iOsnaaente/Totem-Alcool-em-gel/README.md

# Totem Alcool em gel - Projeto mecânico 

Detalhes das etapas de criação de um totem de álcool em gel feito em Solidworks 2019. 

Imagens do totem e referências no repositório Fotos

Desenhos 3D das peças no repositório Peças e compactados .rar em Projeto3D_TotemMecânico.rar 

Montagem do totem no arquivo Totem.STL e via software SolidWorks 2019 no repositório Montagens

Desenhos técnicos das estruturas em MDF no arquivo TotemDesTec.pdf e via software SolidWorks 2019 em TotemDesTec.SLDDRW

Lista de peças utilizadas no arquivo Totem_peças.xls 

Manual de montagem das peças utilizadas no repositório Manual e via software Solidworks Composer 2019 em Totem.smg

Texturas do corpo do totem no repositório Texturas
