iOsnaaente/Totem-Alcool-em-gel/Fotos/Back.jpg

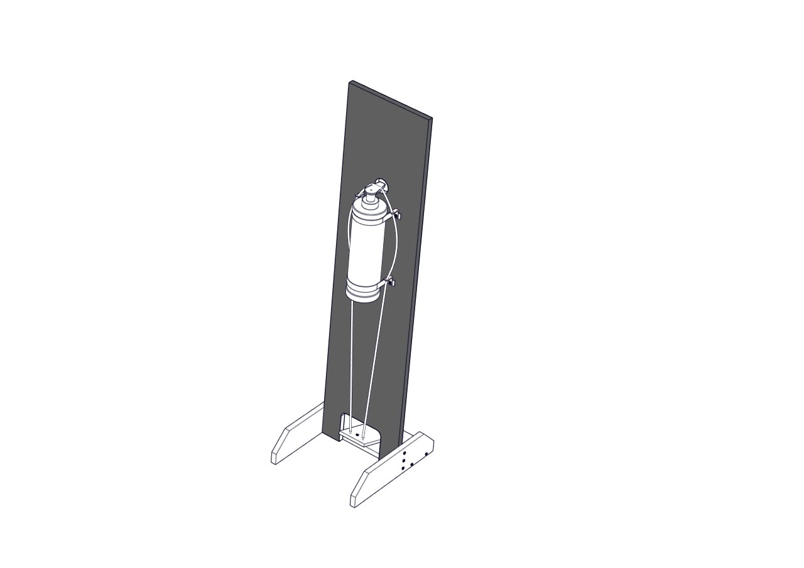
Fotos/Back.jpg
