iOsnaaente/Totem-Alcool-em-gel/Fotos/Explodida.jpg

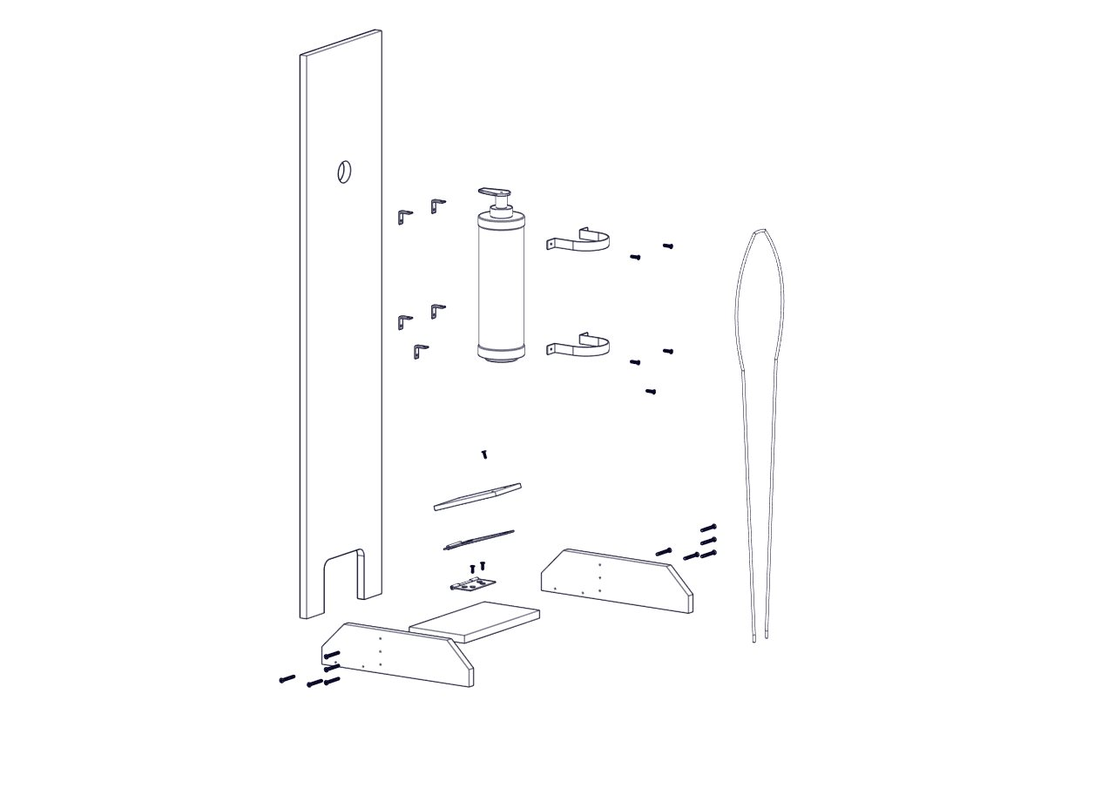
Fotos/Explodida.jpg
