iOsnaaente/Totem-Alcool-em-gel/Fotos/FrontTotem.jpg

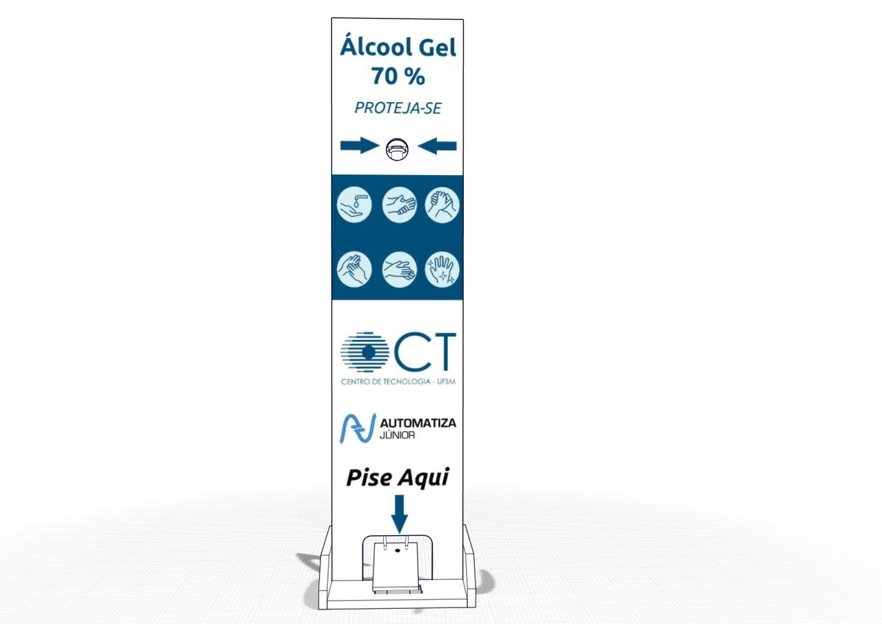
Fotos/FrontTotem.jpg
