iOsnaaente/Totem-Alcool-em-gel/Fotos/peças.jpg

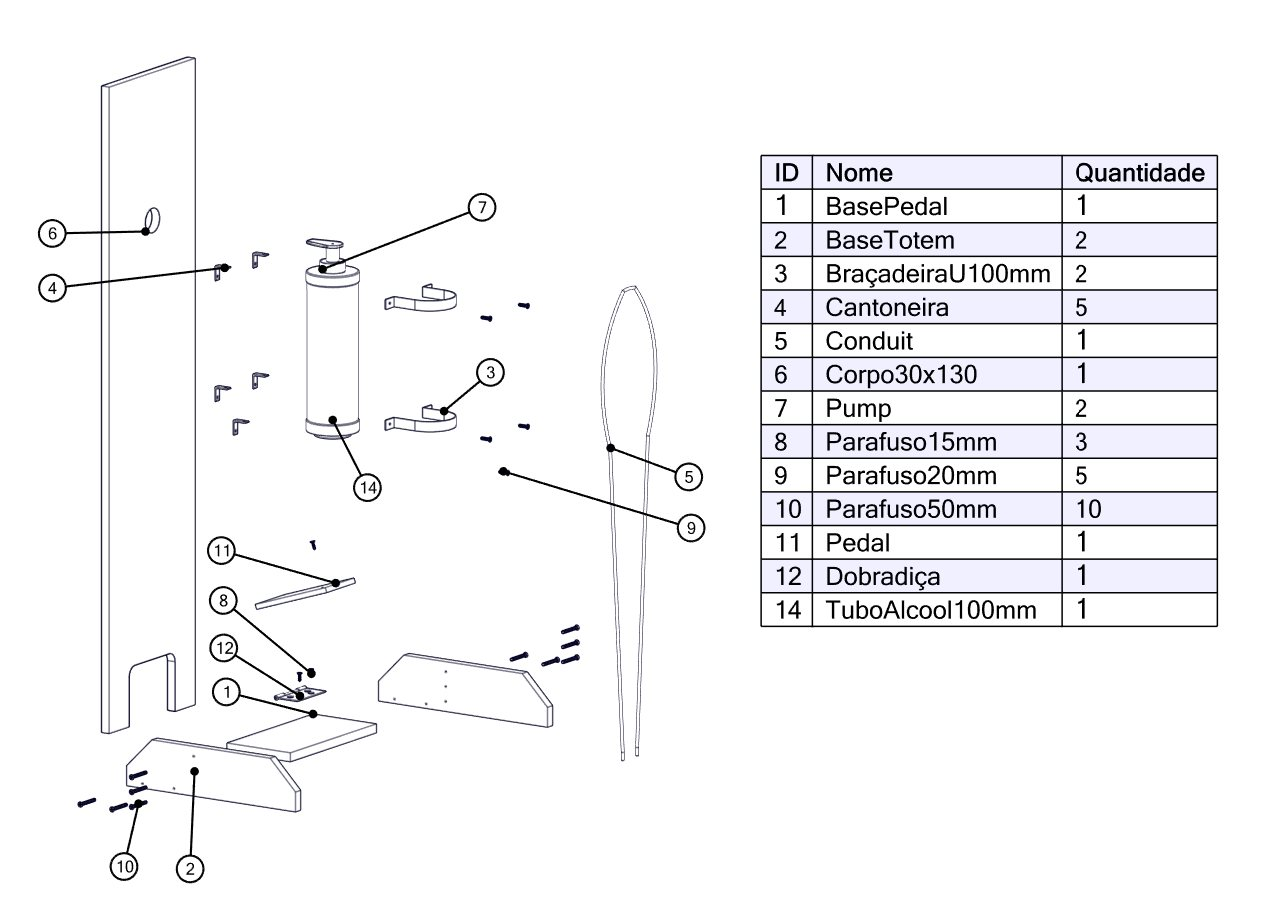
Fotos/peças.jpg
