iOsnaaente/Totem-Alcool-em-gel/Fotos/Totem.jpg

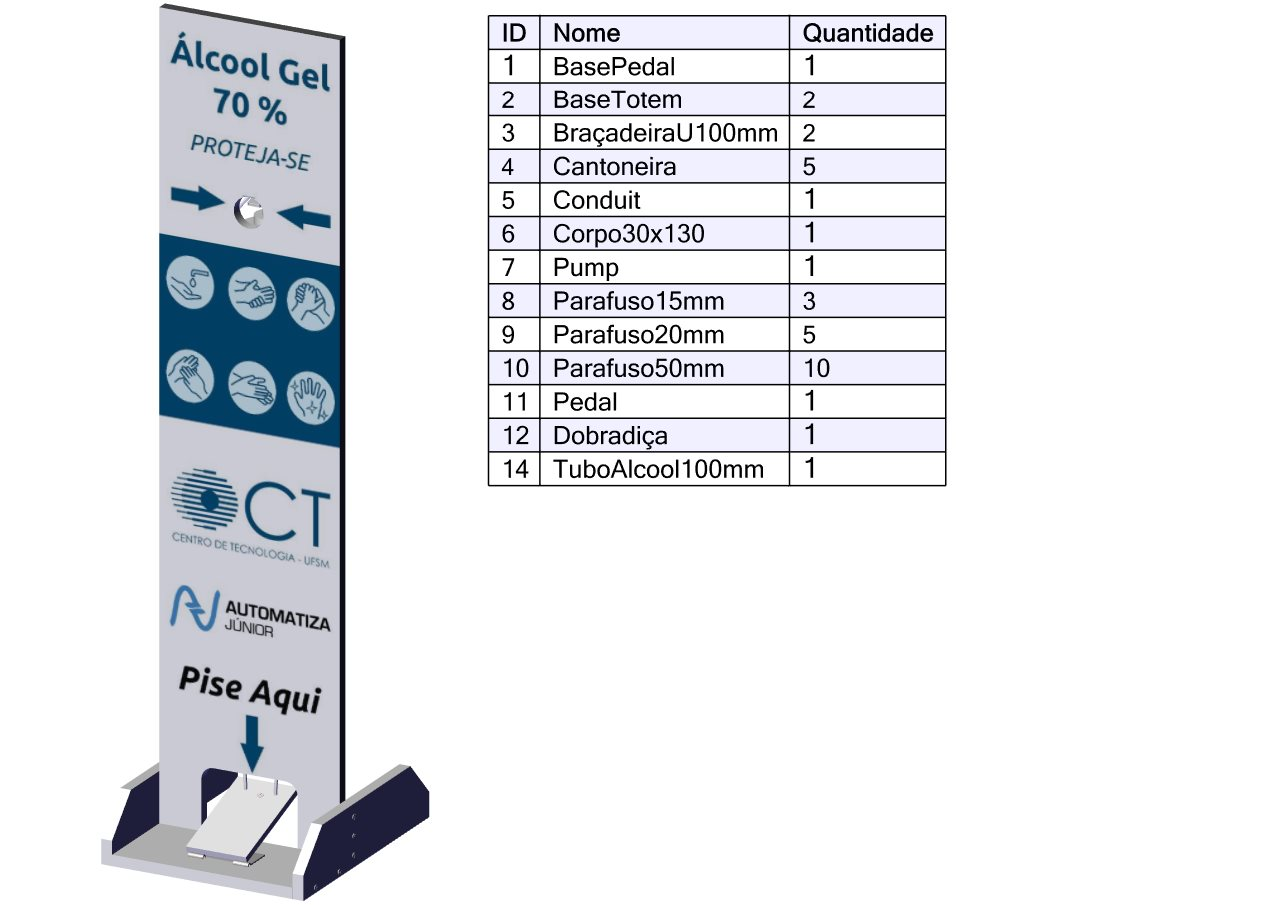
Fotos/Totem.jpg
