iOsnaaente/Totem-Alcool-em-gel/Texturas/ArteProjetar.jpg

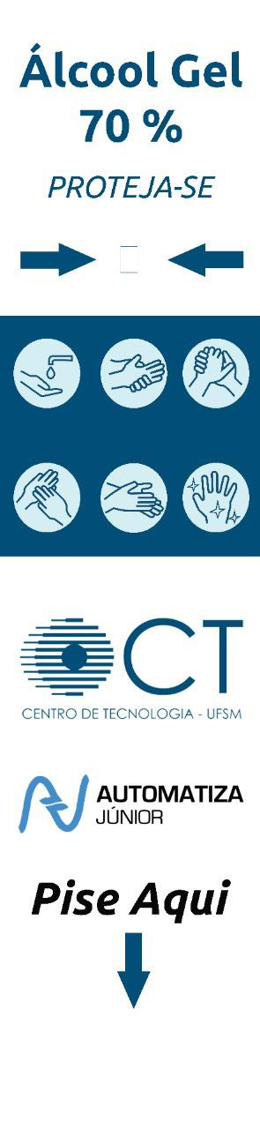
Texturas/ArteProjetar.jpg
