iOsnaaente/Totem-Alcool-em-gel/TOTEM30GRAUS.PNG

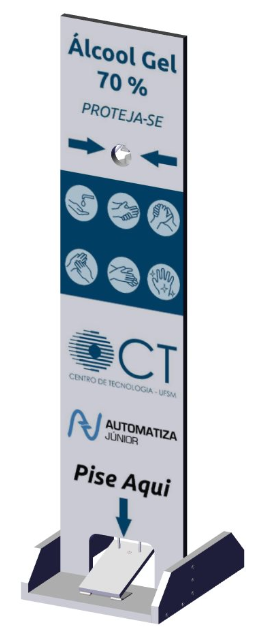
TOTEM30GRAUS.PNG
