iOsnaaente/Totem-Alcool-em-gel/Totem_peças.xls

Nº DO ITEM | Nº DA PEÇA | DESCRIÇÃO | QTD.
1 | Pé do Totem |  | 2
2 | Corpo |  | 1
3 | Pedal |  | 1
4 | Base entre pés |  | 1
5 | TuboAlcool 100mm | Tubo + tampas | 1
6 | Abraçadeira U 100mm |  | 2
7 | Dobradiça | Dobradiça de porteira | 1
8 | Cantoneiras |  | 5
9 | conduit | Conduit + Cabos de aço | 1
10 | Pump |  | 1
11 | parafuso 50mm c | 50mm de comprimento | 10
12 | parafuso 20mm c | 20mm de comprimento | 5
13 | parafuso 15mm c | 15mm de comprimento | 3
14 | Cola 3M | Fixação do pedal | -
15 | Cola pvc | Colagem do cap no cano | -
