iOsnaaente/Totem-Alcool-em-gel/Montagens/Totem.SLDASM

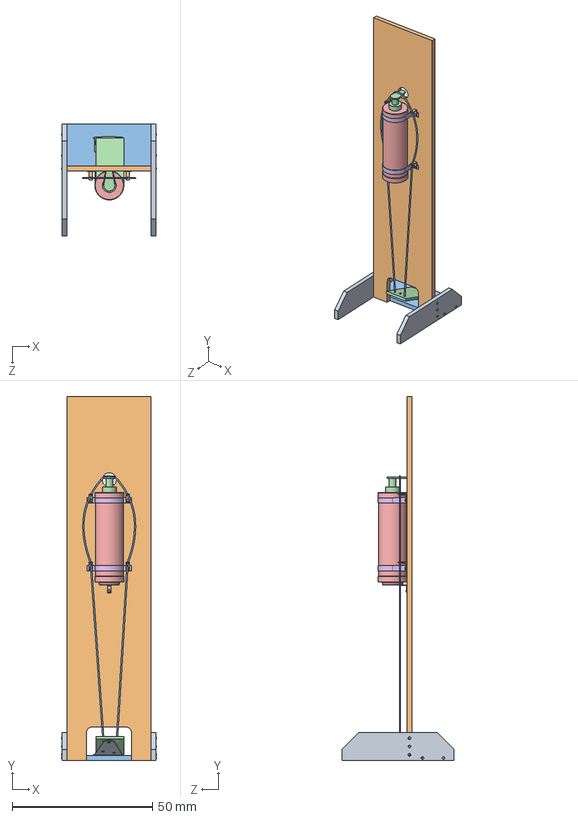
[picture p10: CAD file, 2021-02-19]
Montagens/Totem.SLDASM
34.0 x 130.0 x 40.0 mm
BaseTotem x 2
Corpo30x130
BasePedal_15x30
Pedal
TuboAlcool100mm
BraçadeiraU100mm x 2
PeçaInferior
Pivo
PeçaSuperior
Cantoneira x 5
Conduit_Cabo-de-aço
Pump
Parafuso50mm^Montagem1 x 10
Parafuso20mm^Montagem1 - Copia x 5
Parafuso15mm x 3
