iOsnaaente/Totem-Alcool-em-gel/Peças/Dobradiça/Dobradiça.SLDASM

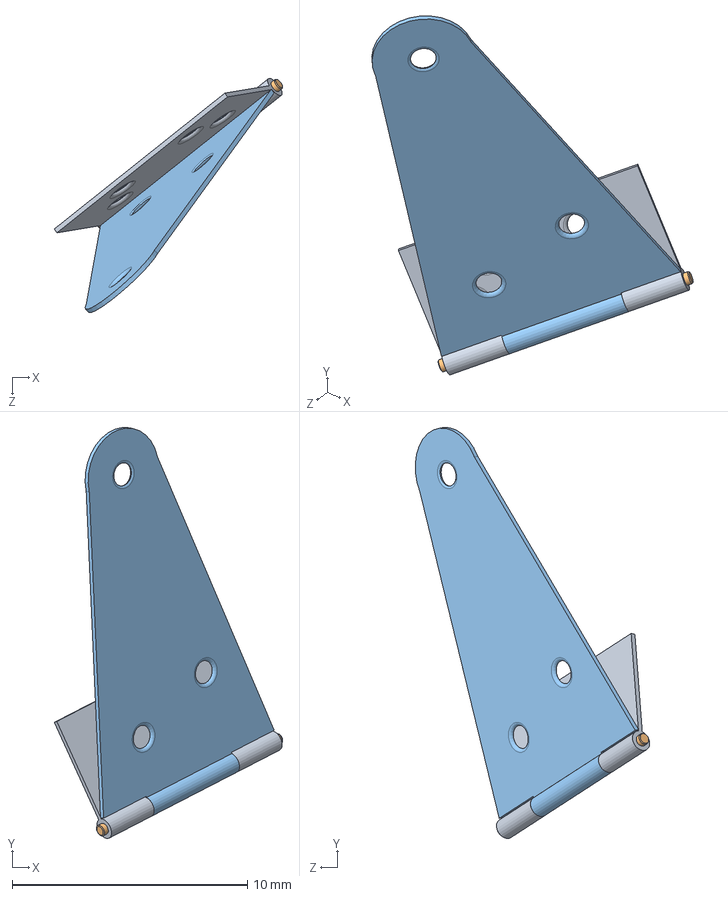
[picture p11: CAD file, 2021-01-08]
Peças/Dobradiça/Dobradiça.SLDASM
9.71 x 17.5 x 9.96 mm
PeçaInferior
Pivo
PeçaSuperior
