iOsnaaente/Totem-Alcool-em-gel/Montagens/Dobradiça.SLDASM

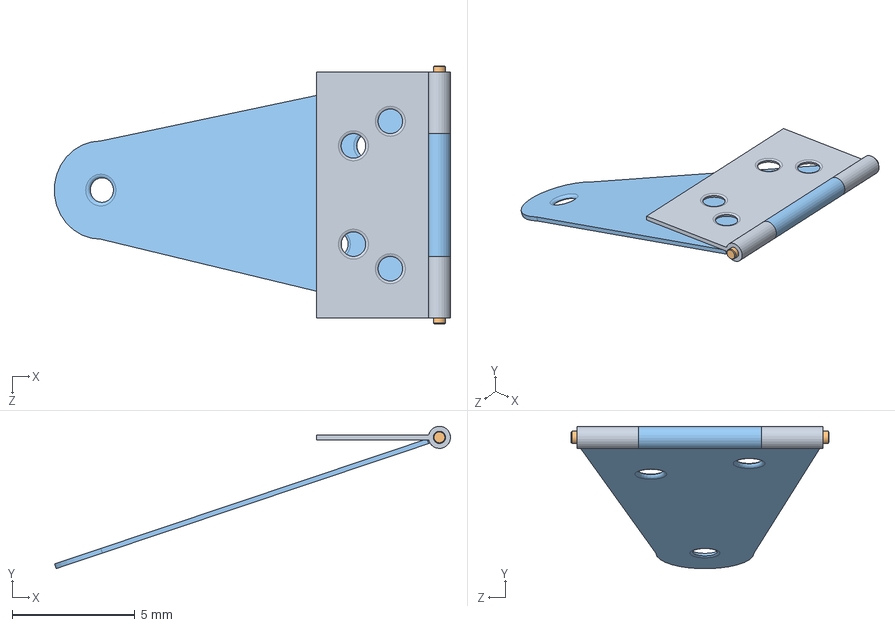
[picture p12: CAD file, 2021-01-08]
Montagens/Dobradiça.SLDASM
16.1 x 5.79 x 10.5 mm
PeçaInferior
Pivo
PeçaSuperior
