iOsnaaente/Totem-Alcool-em-gel/TOTEM_CCNE/TAG-403.SLDASM

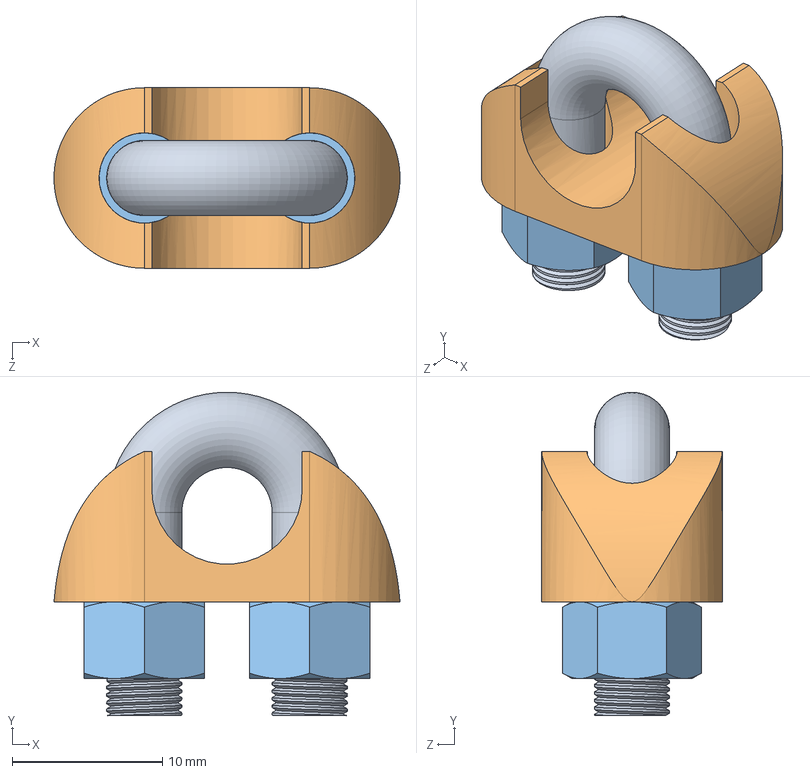
[picture p13: CAD file, 2021-02-19]
TOTEM_CCNE/TAG-403.SLDASM
23.0 x 21.5 x 12.0 mm
TAG-213.1
TAG-213.2
hex nut style 2_am x 2
