iOsnaaente/Totem-Alcool-em-gel/TOTEM_CCNE/TAG-401.SLDASM

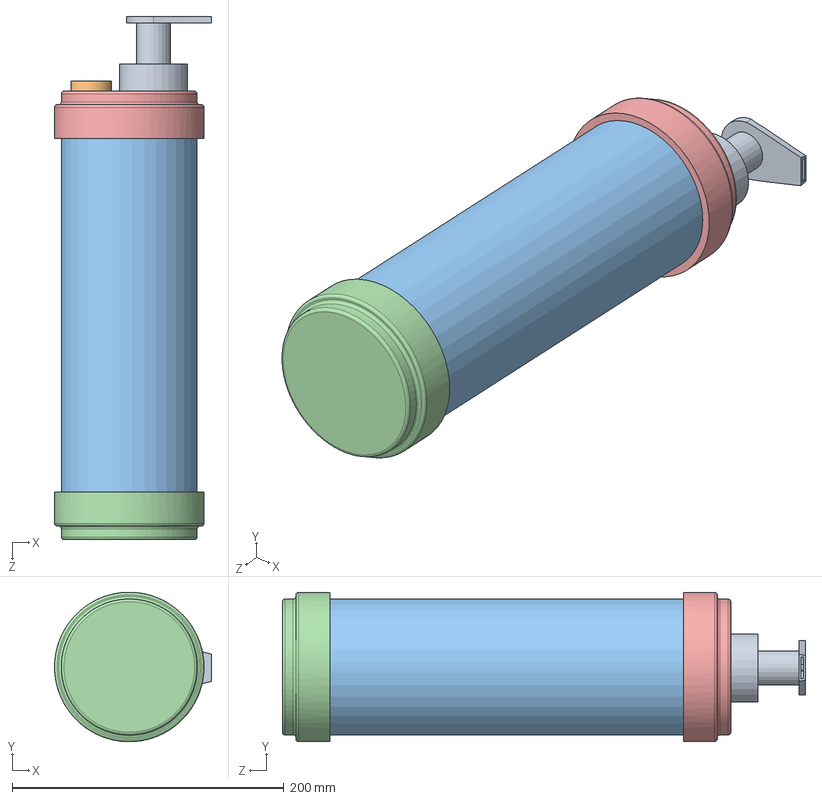
[picture p14: CAD file, 2021-02-19]
TOTEM_CCNE/TAG-401.SLDASM
115.5 x 110.0 x 385.0 mm
TAG-209
TAG-208
TAG-207
TAG-210
TAG-211
