iOsnaaente/Totem-Alcool-em-gel/TOTEM_CCNE/TAG-402.SLDASM

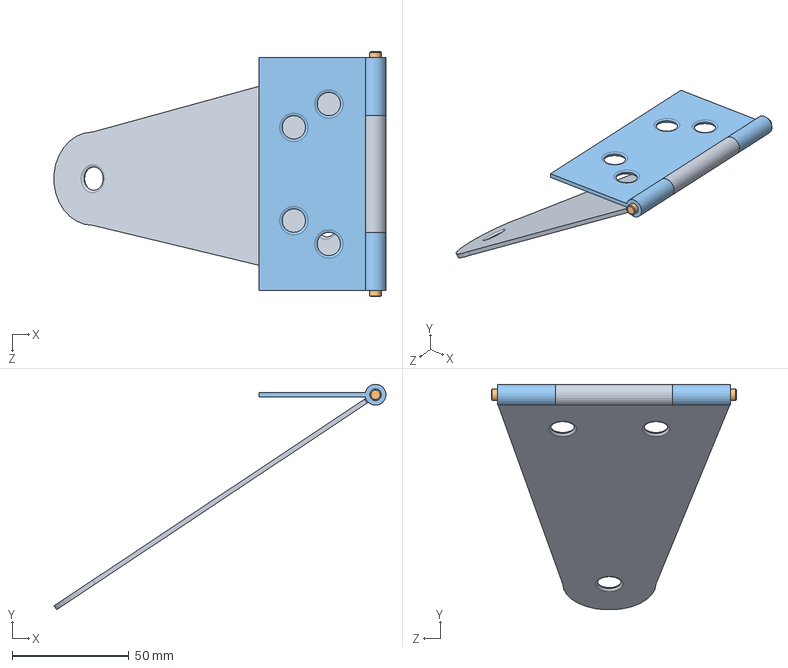
[picture p15: CAD file, 2021-02-19]
TOTEM_CCNE/TAG-402.SLDASM
142.3 x 96.7 x 105.0 mm
TAG-212.1
TAG-212.2
TAG-212.3
