iOsnaaente/Totem-Alcool-em-gel/TOTEM_CCNE/TAG-201.sldprt

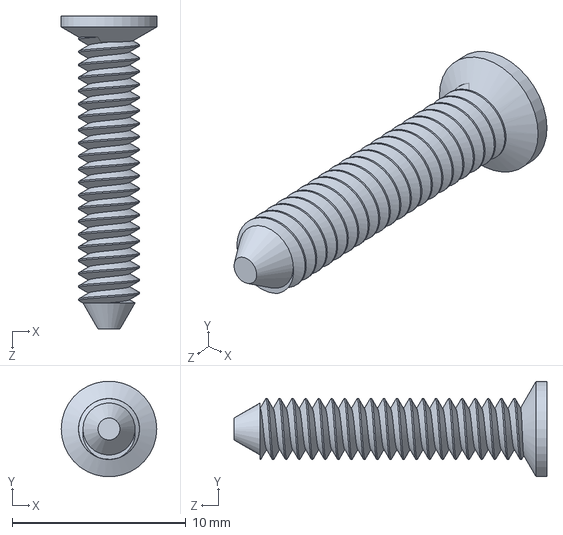
[picture p16: CAD file, 2021-02-19]
TOTEM_CCNE/TAG-201.sldprt
5.50 x 5.48 x 18.0 mm
