iOsnaaente/Totem-Alcool-em-gel/Peças/BaseTotem.SLDPRT

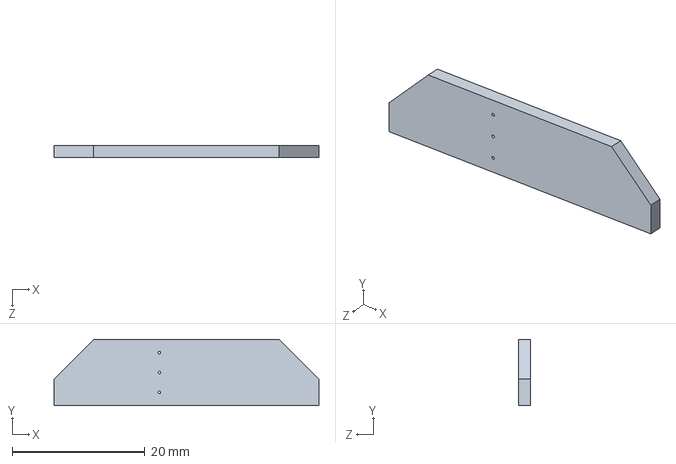
[picture p17: CAD file, 2021-02-19]
Peças/BaseTotem.SLDPRT
40.0 x 10.0 x 1.80 mm
