iOsnaaente/Totem-Alcool-em-gel/Peças/Dobradiça/PeçaInferior.sldprt

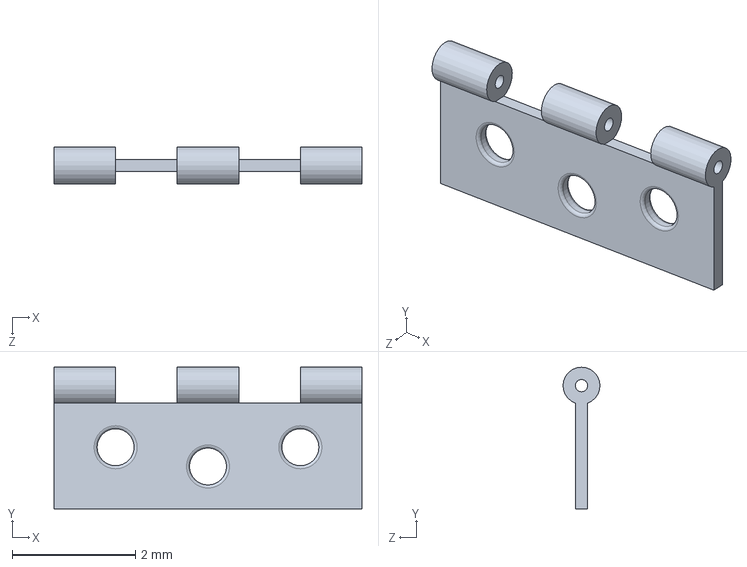
[picture p18: CAD file, 2021-01-08]
Peças/Dobradiça/PeçaInferior.sldprt
5.00 x 2.30 x 0.599 mm
