iOsnaaente/Totem-Alcool-em-gel/TOTEM_CCNE/TAG-104.sldprt

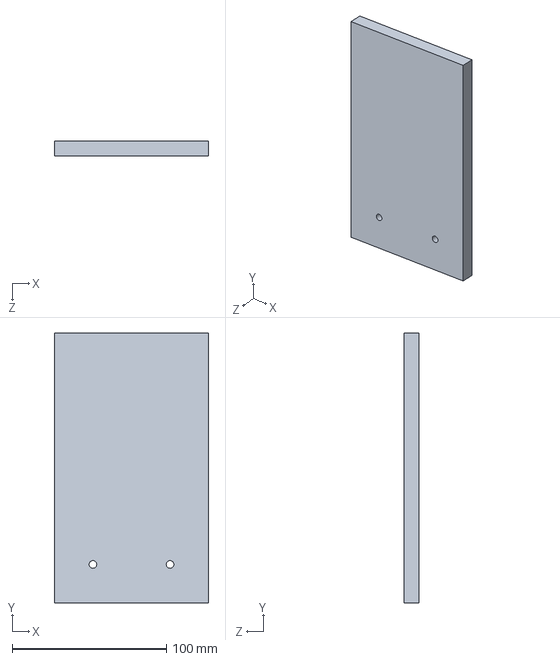
[picture p19: CAD file, 2021-02-19]
TOTEM_CCNE/TAG-104.sldprt
100.0 x 175.0 x 10.0 mm
