iOsnaaente/Totem-Alcool-em-gel/Peças/Pedal.sldprt

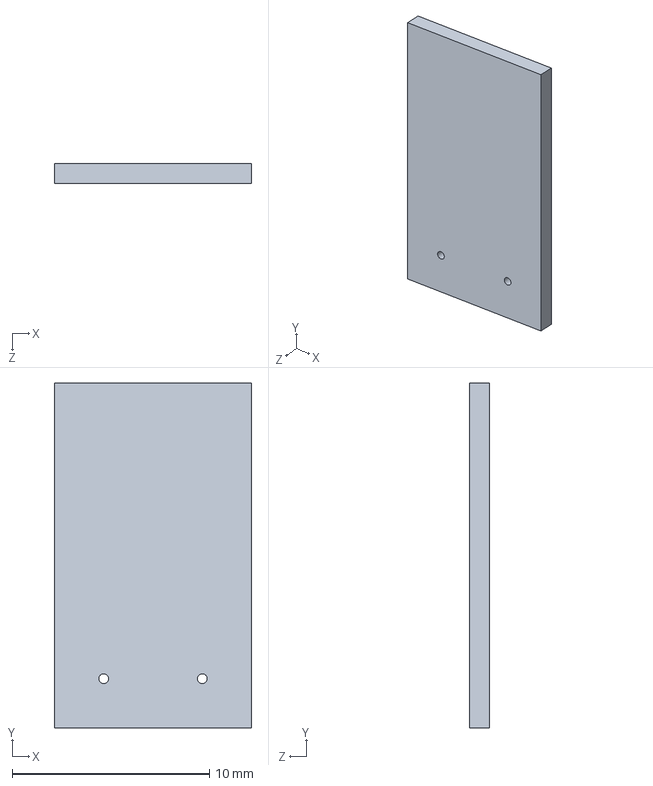
[picture p20: CAD file, 2021-01-19]
Peças/Pedal.sldprt
10.00 x 17.5 x 1.00 mm
