iOsnaaente/Totem-Alcool-em-gel/TOTEM_CCNE/TAG-212.1.sldprt

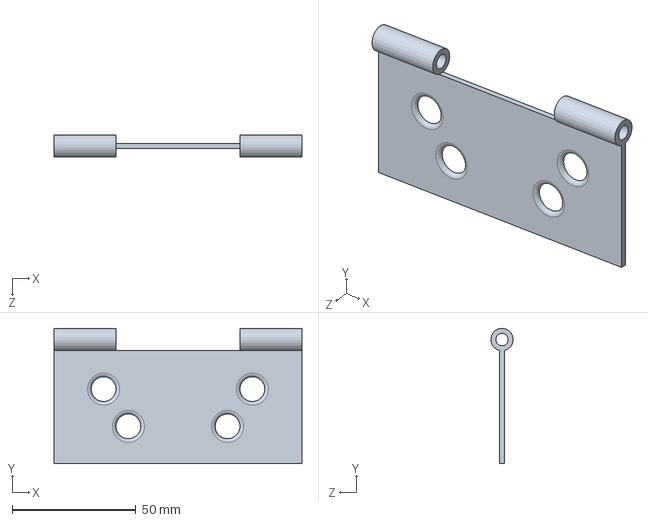
[picture p21: CAD file, 2021-02-19]
TOTEM_CCNE/TAG-212.1.sldprt
100.0 x 54.5 x 8.97 mm
