iOsnaaente/Totem-Alcool-em-gel/Peças/Corpo30x130.SLDPRT

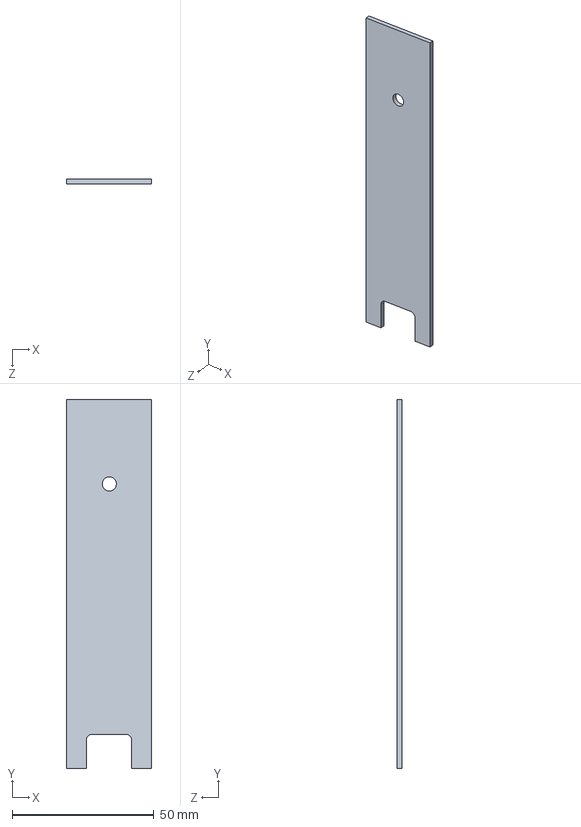
[picture p22: CAD file, 2021-01-08]
Peças/Corpo30x130.SLDPRT
30.0 x 130.0 x 1.80 mm
