iOsnaaente/Totem-Alcool-em-gel/TOTEM_CCNE/TAG-204.sldprt

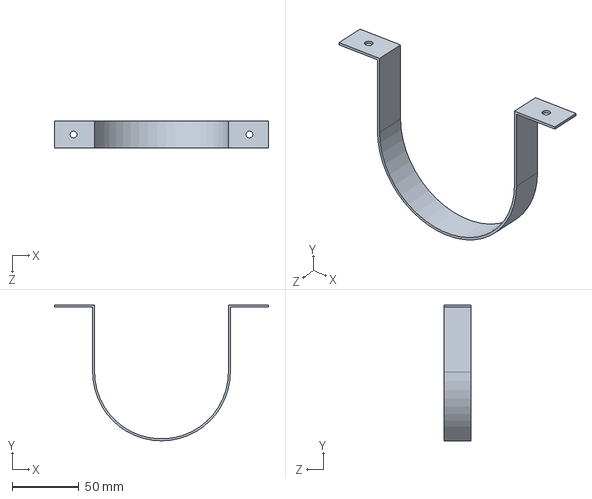
[picture p23: CAD file, 2021-02-19]
TOTEM_CCNE/TAG-204.sldprt
160.0 x 101.5 x 20.0 mm
