iOsnaaente/Totem-Alcool-em-gel/Peças/Cantoneira_pequena.sldprt

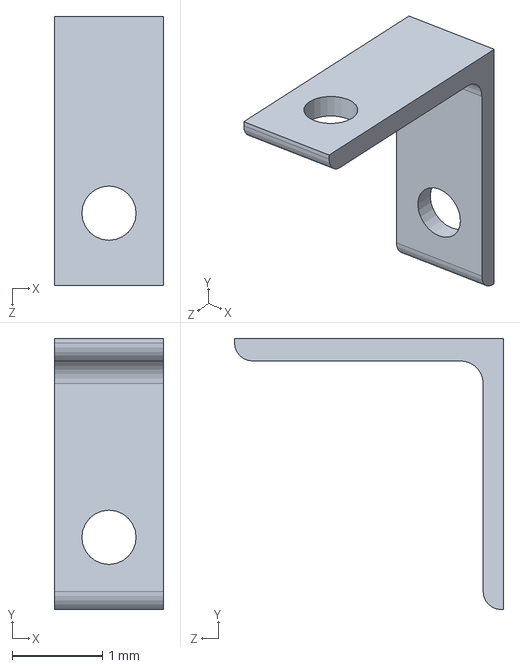
[picture p24: CAD file, 2021-01-08]
Peças/Cantoneira_pequena.sldprt
1.20 x 3.00 x 2.98 mm
