iOsnaaente/Totem-Alcool-em-gel/TOTEM_CCNE/TAG-304.SLDPRT

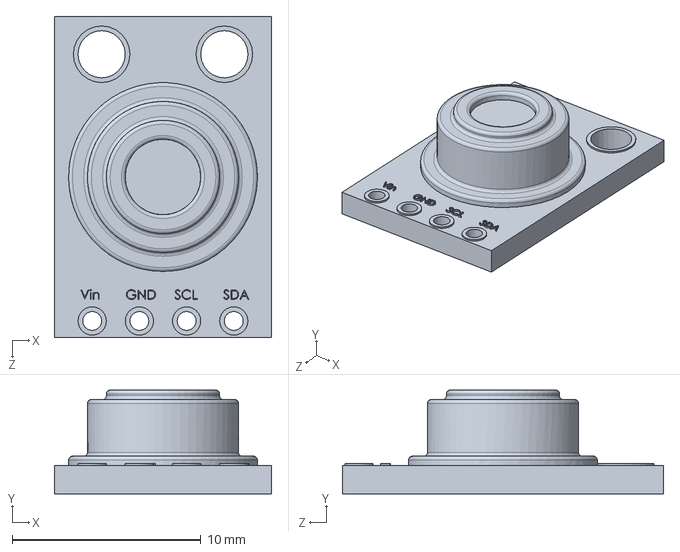
[picture p25: CAD file, 2021-02-19]
TOTEM_CCNE/TAG-304.SLDPRT
11.5 x 5.50 x 17.0 mm
