iOsnaaente/Totem-Alcool-em-gel/Peças/TuboAlcool100mm.sldprt

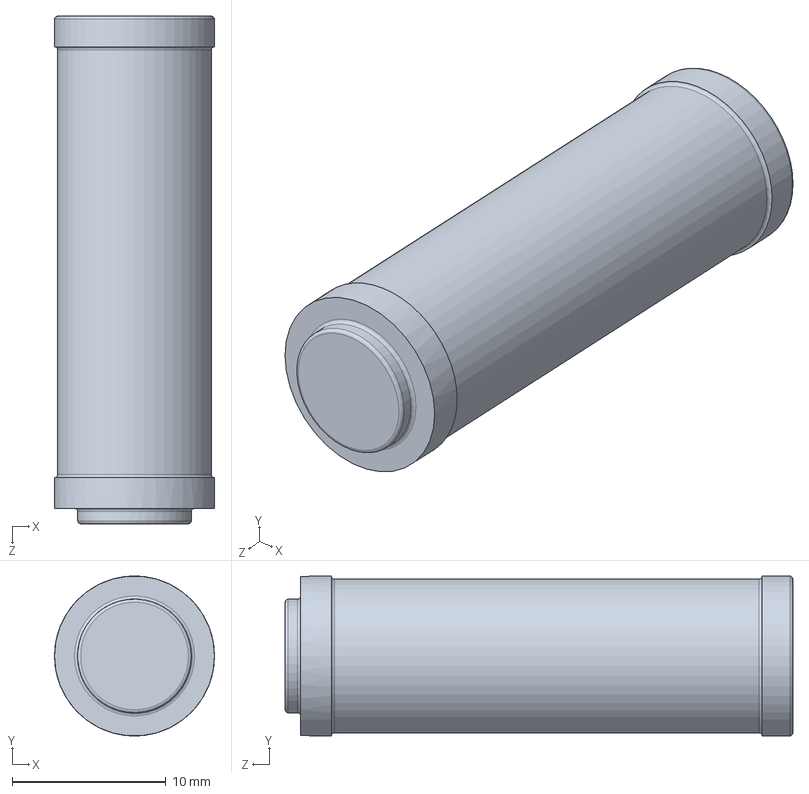
[picture p26: CAD file, 2021-01-08]
Peças/TuboAlcool100mm.sldprt
10.4 x 10.4 x 33.0 mm
