iOsnaaente/Totem-Alcool-em-gel/TOTEM_CCNE/TAG-102.SLDPRT

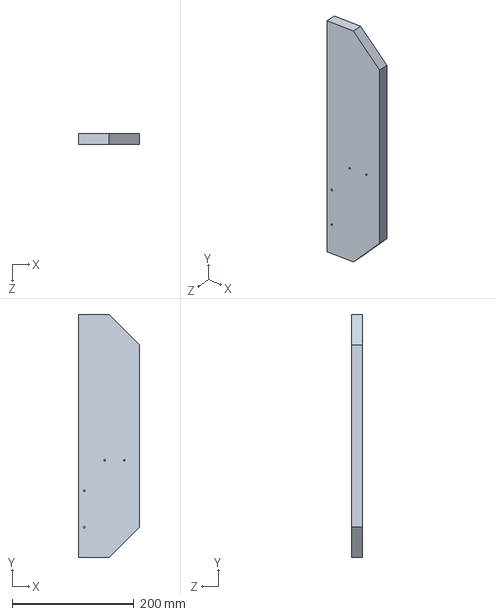
[picture p27: CAD file, 2021-02-19]
TOTEM_CCNE/TAG-102.SLDPRT
100.0 x 400.0 x 18.0 mm
