iOsnaaente/Totem-Alcool-em-gel/Peças/Pump.sldprt

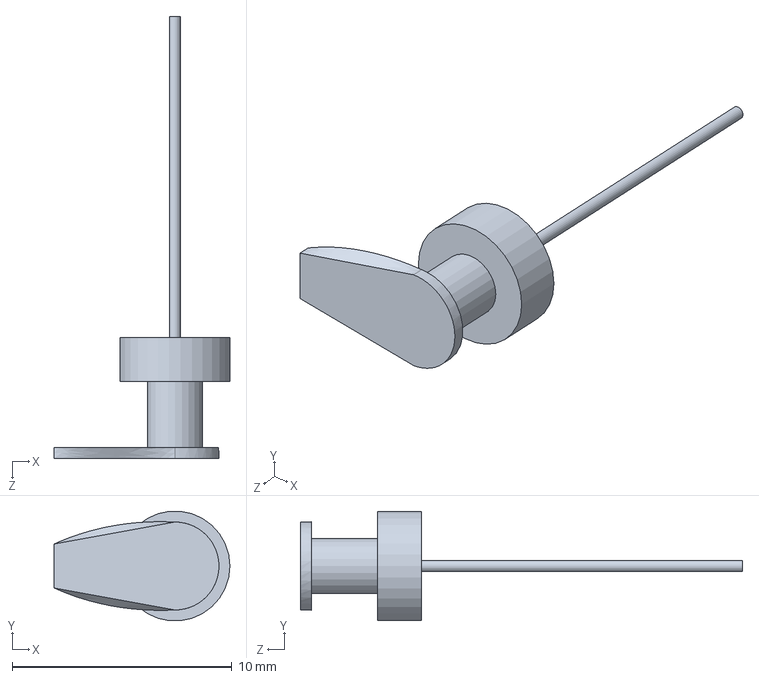
[picture p28: CAD file, 2021-01-08]
Peças/Pump.sldprt
8.00 x 4.97 x 20.1 mm
