iOsnaaente/Totem-Alcool-em-gel/TOTEM_CCNE/TAG-101.sldprt

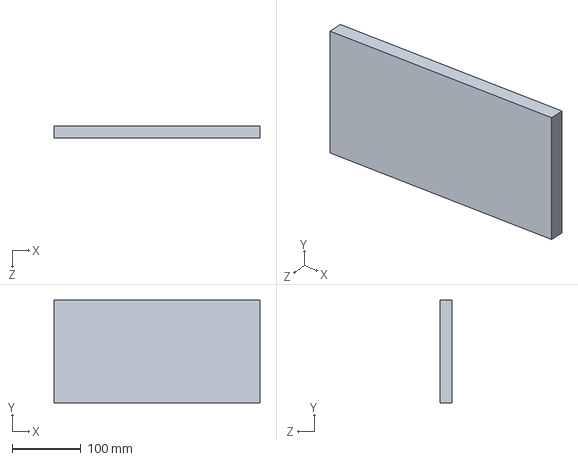
[picture p29: CAD file, 2021-02-19]
TOTEM_CCNE/TAG-101.sldprt
300.0 x 150.0 x 18.0 mm
