iOsnaaente/Totem-Alcool-em-gel/TOTEM_CCNE/TAG-207.sldprt

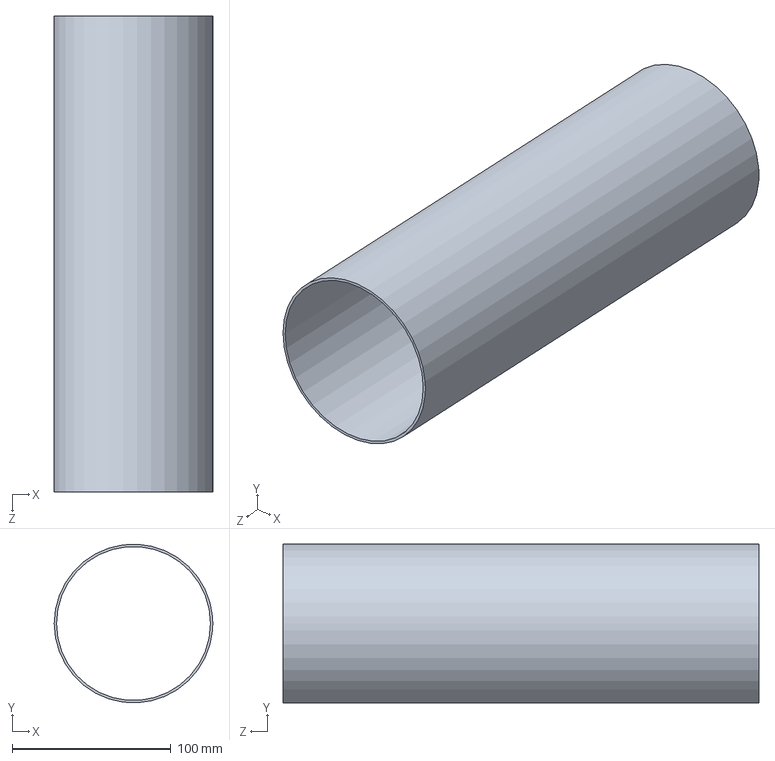
[picture p30: CAD file, 2021-02-19]
TOTEM_CCNE/TAG-207.sldprt
100.0 x 99.9 x 300.0 mm
