iOsnaaente/Totem-Alcool-em-gel/Peças/Parafuso20mm^Montagem1 - Copia.sldprt

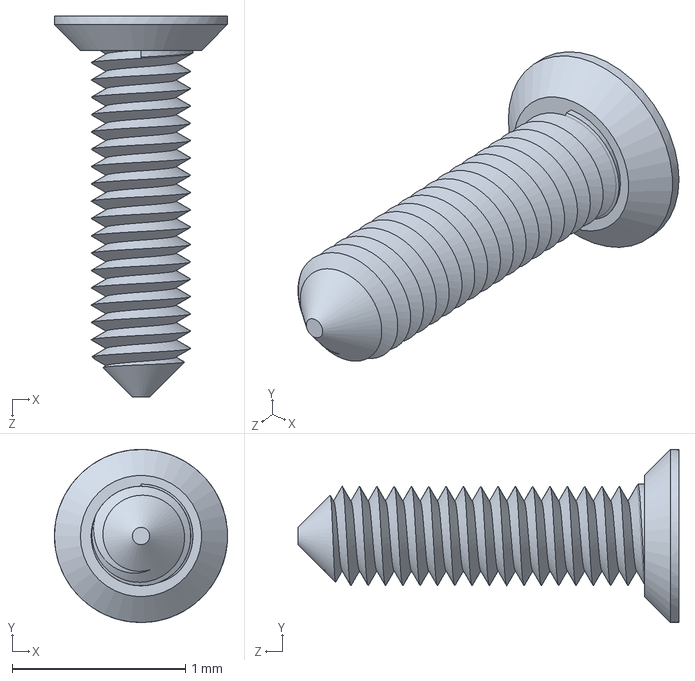
[picture p31: CAD file, 2021-01-08]
Peças/Parafuso20mm^Montagem1 - Copia.sldprt
1.00 x 0.999 x 2.20 mm
