iOsnaaente/Totem-Alcool-em-gel/TOTEM_CCNE/TAG-212.3.SLDPRT

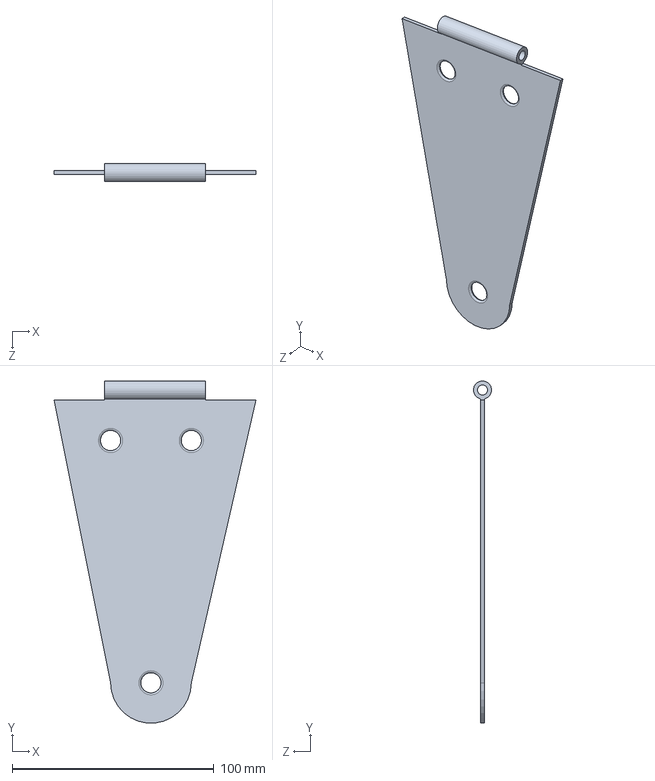
[picture p32: CAD file, 2021-02-19]
TOTEM_CCNE/TAG-212.3.SLDPRT
100.0 x 169.4 x 8.97 mm
