iOsnaaente/Totem-Alcool-em-gel/Peças/Parafuso15mm.sldprt

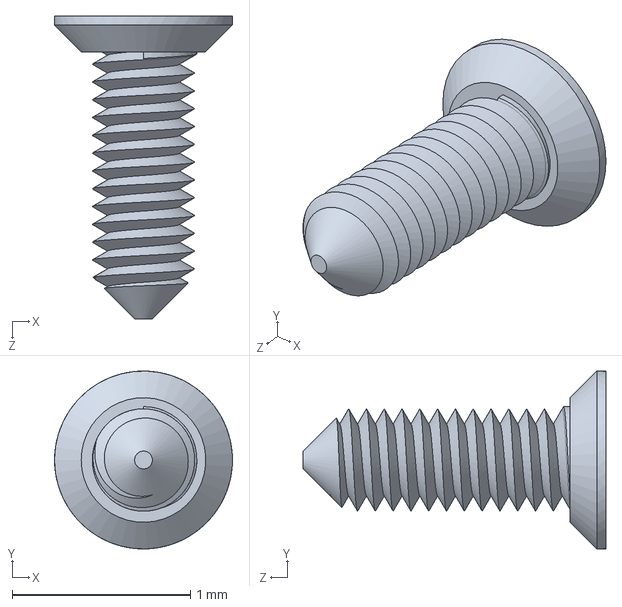
[picture p33: CAD file, 2021-01-08]
Peças/Parafuso15mm.sldprt
1.00 x 0.999 x 1.70 mm
