iOsnaaente/Totem-Alcool-em-gel/TOTEM_CCNE/TAG-203.sldprt

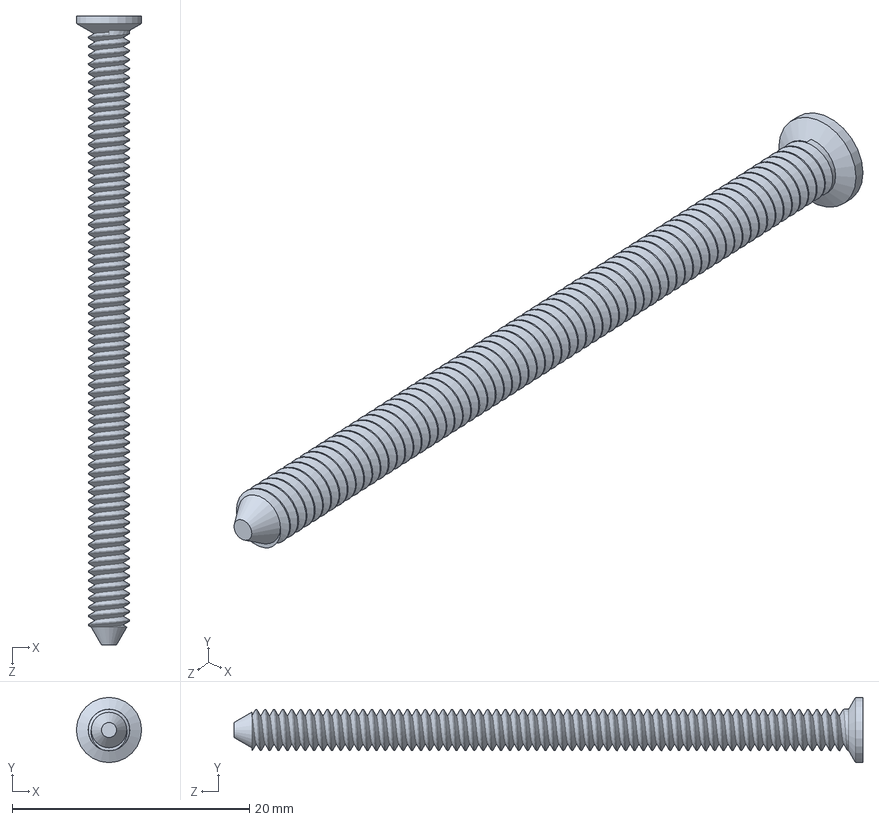
[picture p34: CAD file, 2021-02-19]
TOTEM_CCNE/TAG-203.sldprt
5.50 x 5.50 x 53.0 mm
