iOsnaaente/Totem-Alcool-em-gel/Peças/Parafuso50mm^Montagem1.sldprt

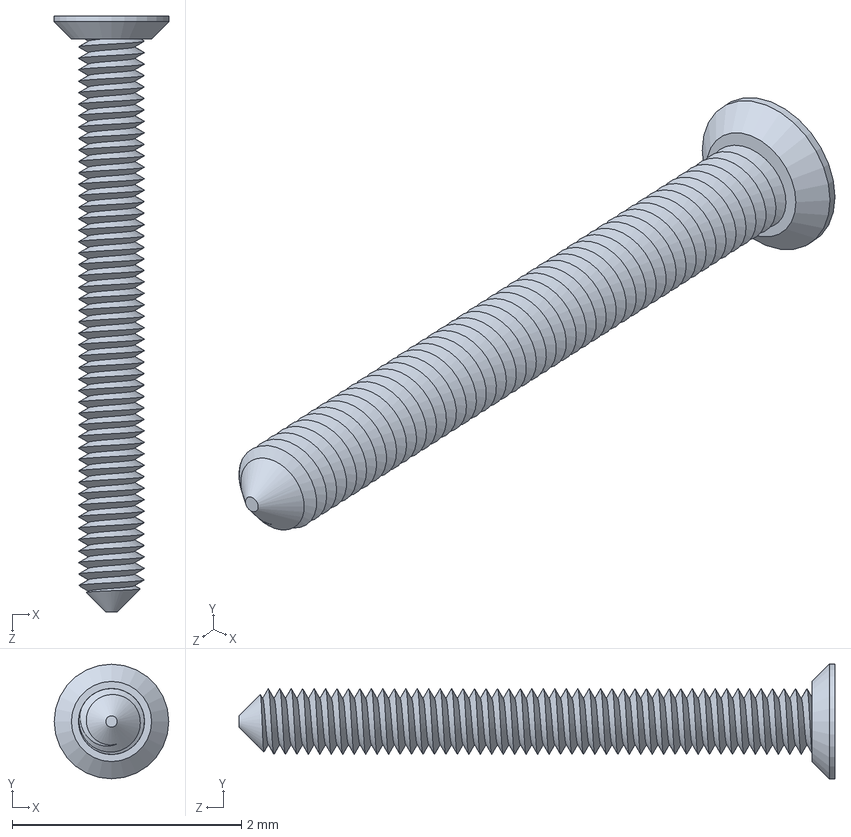
[picture p35: CAD file, 2021-01-08]
Peças/Parafuso50mm^Montagem1.sldprt
1.00 x 1.00 x 5.20 mm
