iOsnaaente/Totem-Alcool-em-gel/TOTEM_CCNE/TAG-213.1.SLDPRT

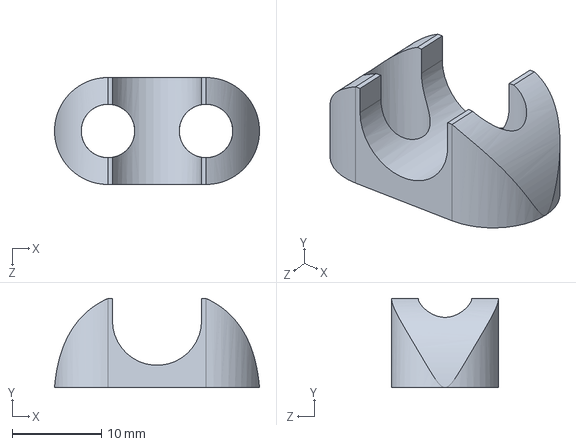
[picture p37: CAD file, 2021-02-19]
TOTEM_CCNE/TAG-213.1.SLDPRT
23.0 x 10.0 x 12.0 mm
