iOsnaaente/Totem-Alcool-em-gel/TOTEM_CCNE/TAG-205.sldprt

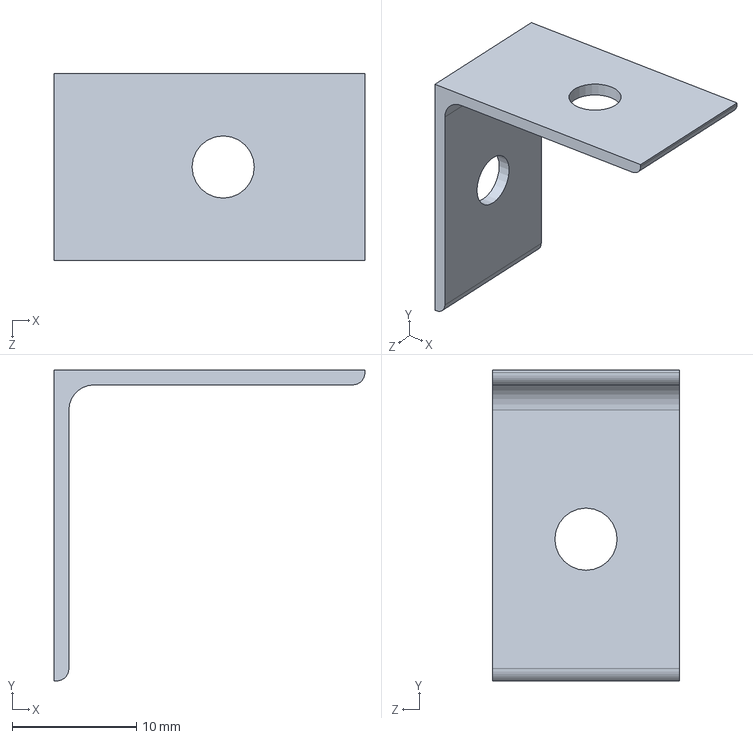
[picture p38: CAD file, 2021-02-19]
TOTEM_CCNE/TAG-205.sldprt
25.0 x 25.0 x 15.0 mm
