iOsnaaente/Totem-Alcool-em-gel/TOTEM_CCNE/TAG-103.SLDPRT

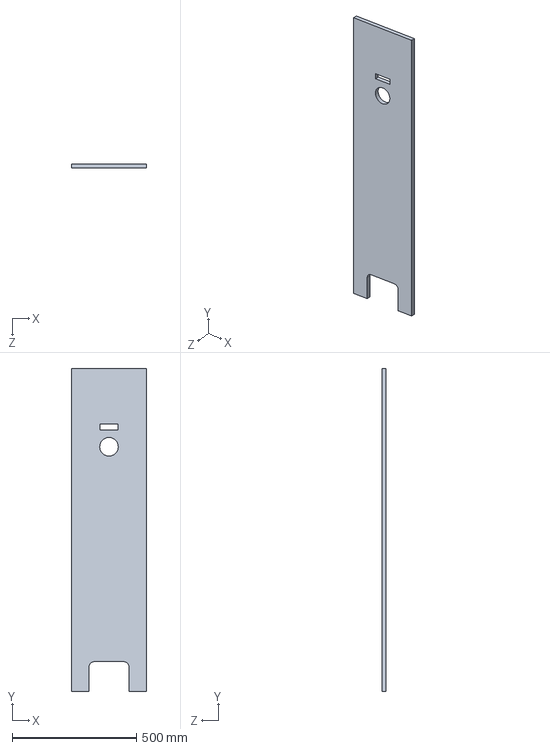
[picture p39: CAD file, 2021-02-19]
TOTEM_CCNE/TAG-103.SLDPRT
300.0 x 1300.0 x 18.0 mm
