iOsnaaente/Totem-Alcool-em-gel/TOTEM_CCNE/TAG-213.2.SLDPRT

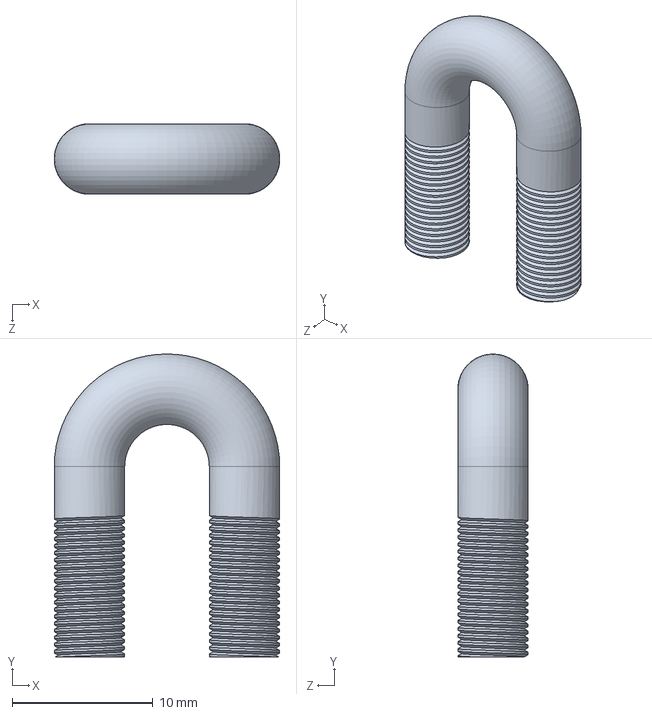
[picture p41: CAD file, 2021-02-19]
TOTEM_CCNE/TAG-213.2.SLDPRT
16.0 x 21.5 x 5.00 mm
