iOsnaaente/Totem-Alcool-em-gel/TOTEM_CCNE/TAG-305.sldprt

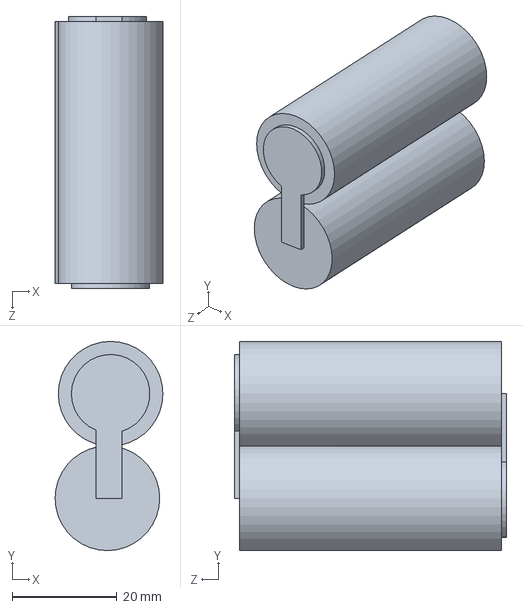
[picture p42: CAD file, 2021-02-19]
TOTEM_CCNE/TAG-305.sldprt
20.6 x 40.0 x 52.0 mm
