iOsnaaente/Totem-Alcool-em-gel/TOTEM_CCNE/TAG-209.sldprt

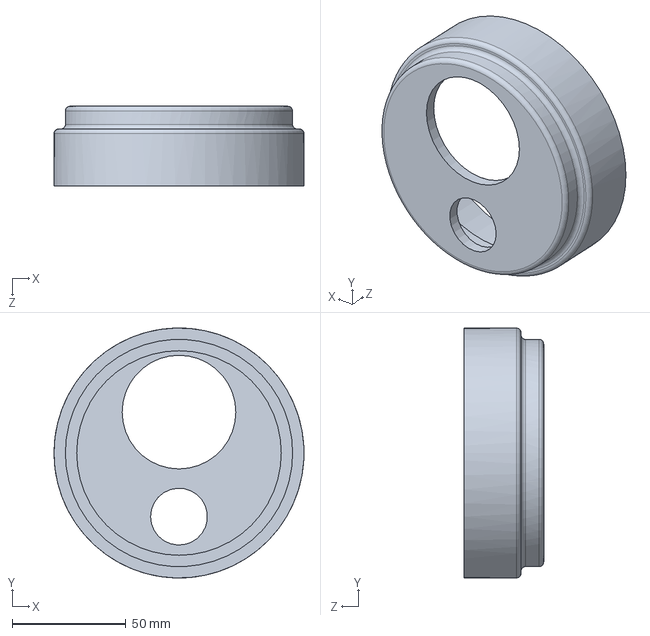
[picture p43: CAD file, 2021-02-19]
TOTEM_CCNE/TAG-209.sldprt
110.0 x 110.0 x 35.0 mm
