iOsnaaente/Totem-Alcool-em-gel/TOTEM_CCNE/TAG-211.sldprt

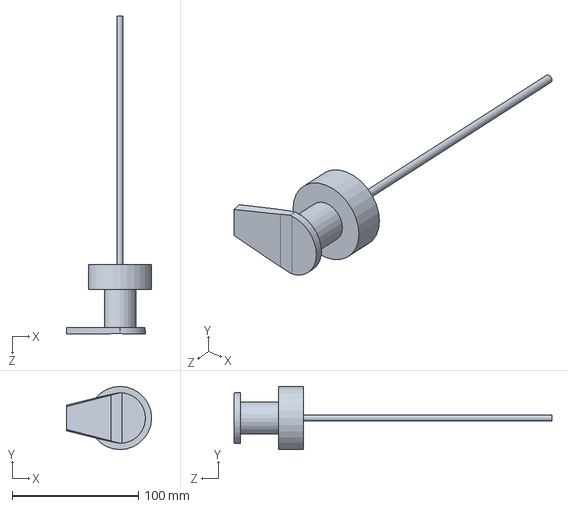
[picture p44: CAD file, 2021-02-19]
TOTEM_CCNE/TAG-211.sldprt
67.5 x 50.0 x 251.5 mm
