iOsnaaente/Totem-Alcool-em-gel/TOTEM_CCNE/TAG-202.sldprt

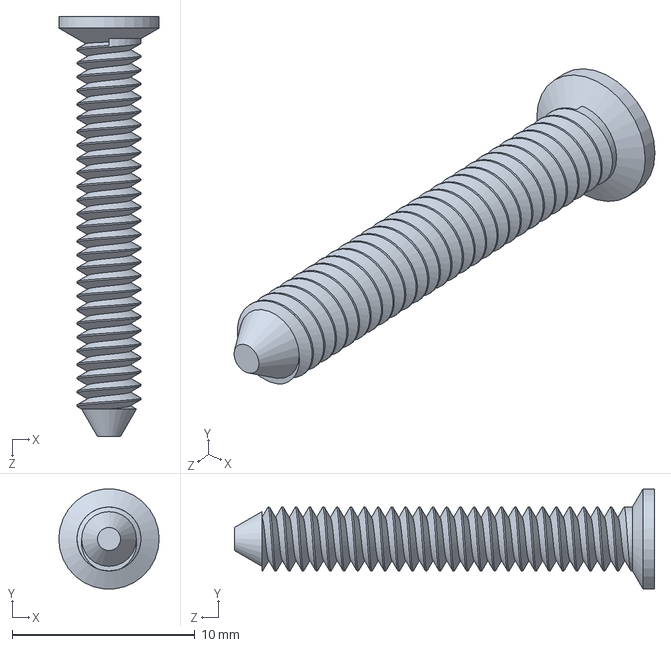
[picture p45: CAD file, 2021-02-19]
TOTEM_CCNE/TAG-202.sldprt
5.50 x 5.47 x 23.0 mm
