iOsnaaente/Totem-Alcool-em-gel/TOTEM_CCNE/TAG-212.2.sldprt

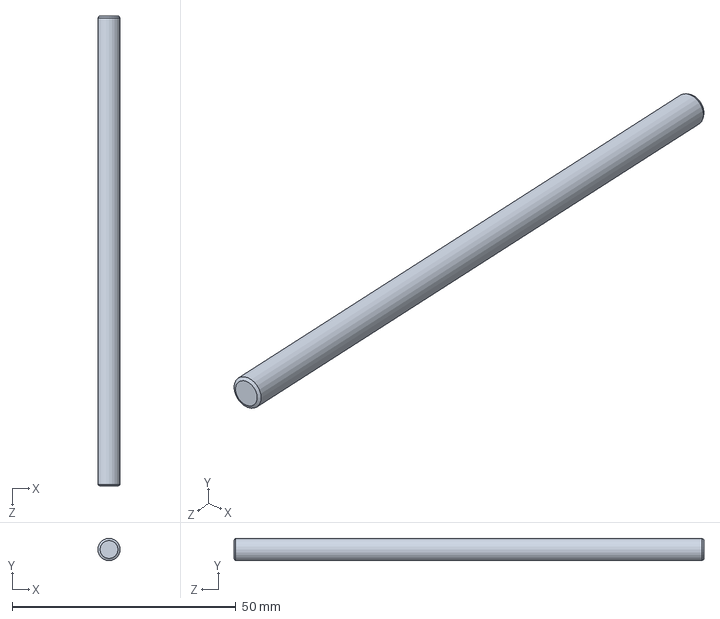
[picture p46: CAD file, 2021-02-19]
TOTEM_CCNE/TAG-212.2.sldprt
5.00 x 5.00 x 105.0 mm
