iOsnaaente/Totem-Alcool-em-gel/TOTEM_CCNE/TAG-210.sldprt

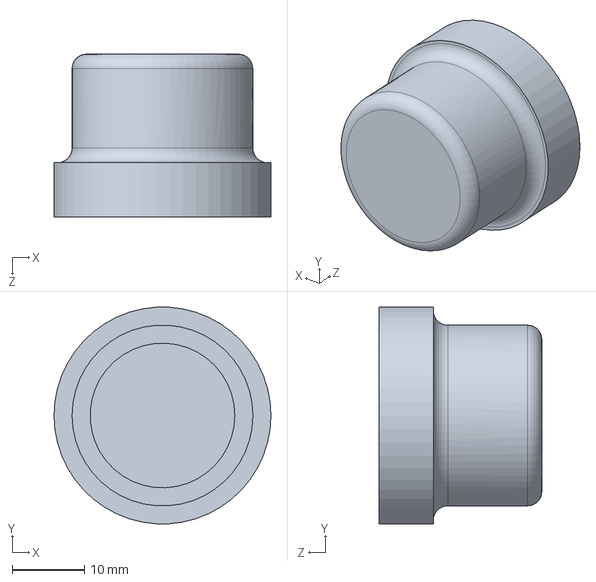
[picture p47: CAD file, 2021-02-19]
TOTEM_CCNE/TAG-210.sldprt
30.0 x 29.9 x 22.5 mm
