iOsnaaente/Totem-Alcool-em-gel/TOTEM_CCNE/TAG-206.sldprt

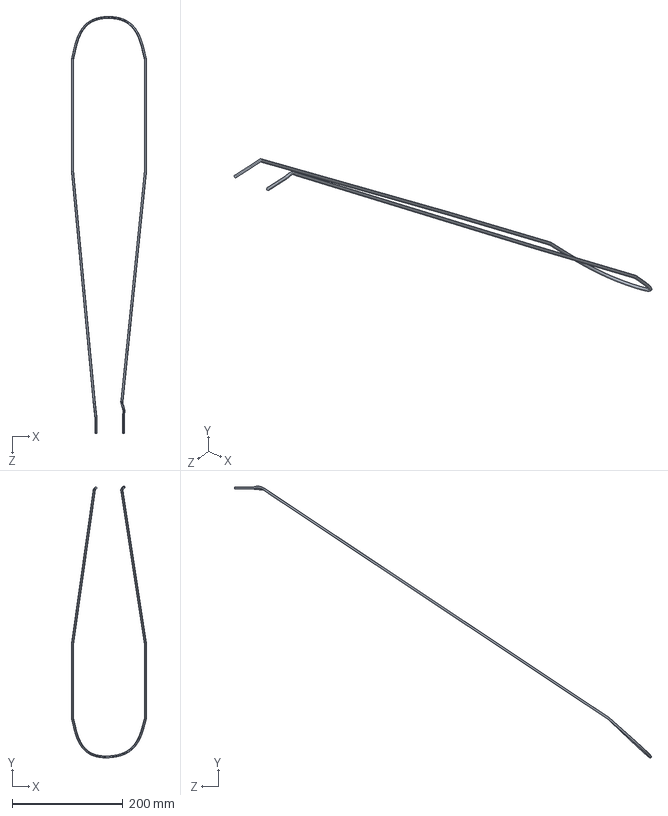
[picture p48: CAD file, 2021-02-19]
TOTEM_CCNE/TAG-206.sldprt
135.5 x 490.3 x 752.5 mm
