iOsnaaente/Totem-Alcool-em-gel/TOTEM_CCNE/TAG-301.SLDPRT

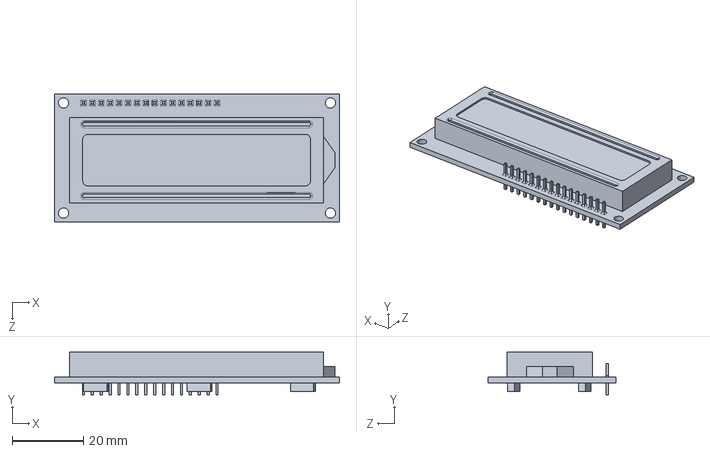
[picture p49: CAD file, 2021-02-19]
TOTEM_CCNE/TAG-301.SLDPRT
80.0 x 12.0 x 36.0 mm
