iOsnaaente/Totem-Alcool-em-gel/TOTEM_CCNE/TAG-105.sldprt

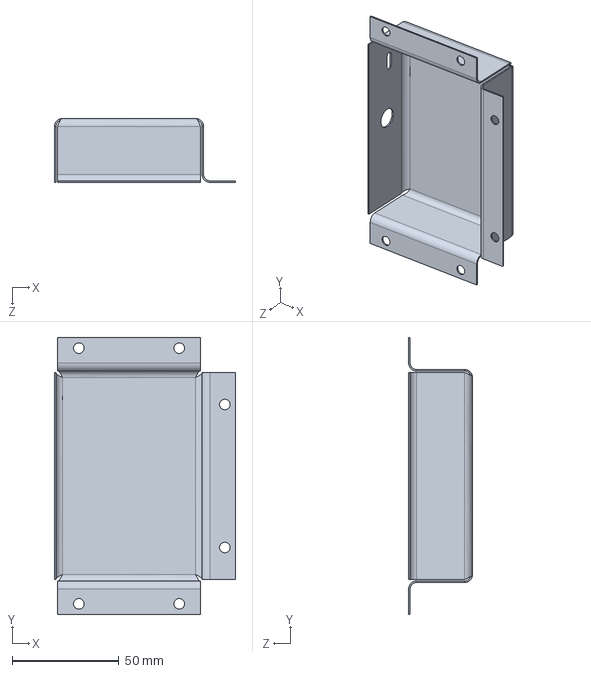
[picture p50: CAD file, 2021-02-19]
TOTEM_CCNE/TAG-105.sldprt
85.0 x 130.0 x 30.0 mm
