iOsnaaente/Totem-Alcool-em-gel/(list of files, cad)

Other CAD files:
Peças/Conduit_Cabo-de-aço.sldprt
Peças/Dobradiça/Pivo.sldprt
Peças/Dobradiça/PeçaSuperior.SLDPRT
Peças/BasePedal_15x30.sldprt
Peças/BraçadeiraU100mm.sldprt
Peças/Cantoneira.sldprt
TOTEM_CCNE/TAG-101.SLDDRW
TOTEM_CCNE/TAG-102.SLDDRW
TOTEM_CCNE/TAG-103.SLDDRW
TOTEM_CCNE/TAG-104.SLDDRW
TOTEM_CCNE/TAG-105.SLDDRW
TOTEM_CCNE/TAG-401.SLDDRW
TOTEM_CCNE/TAG-501.SLDDRW
TotemDesTec.SLDDRW
