iOsnaaente/Totem-Alcool-em-gel/Manual/PNGs/1.png

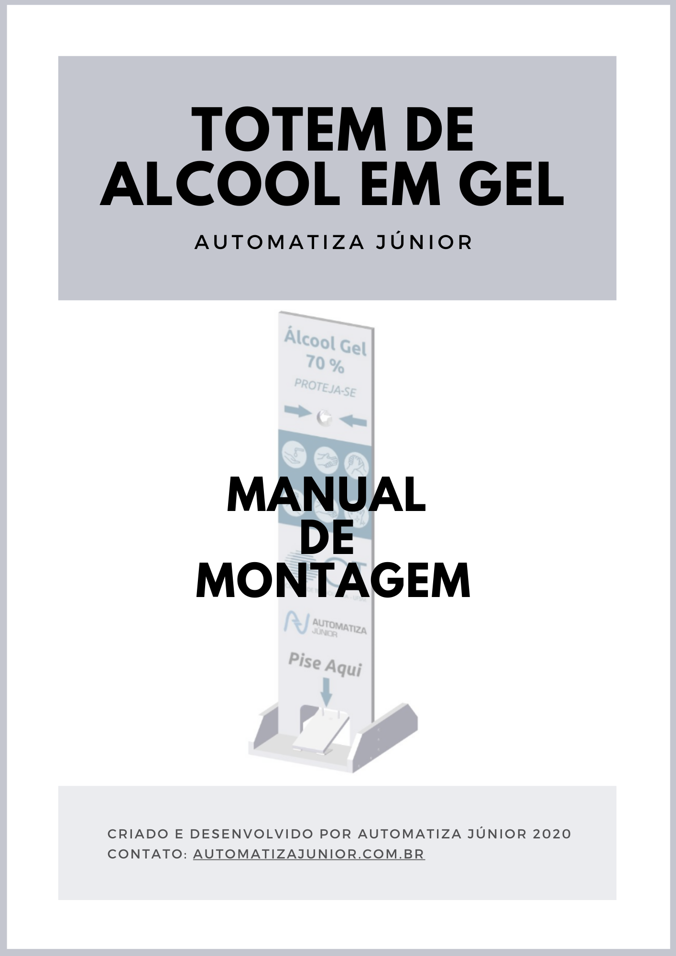
Manual/PNGs/1.png
