iOsnaaente/Totem-Alcool-em-gel/Manual/PNGs/2.png

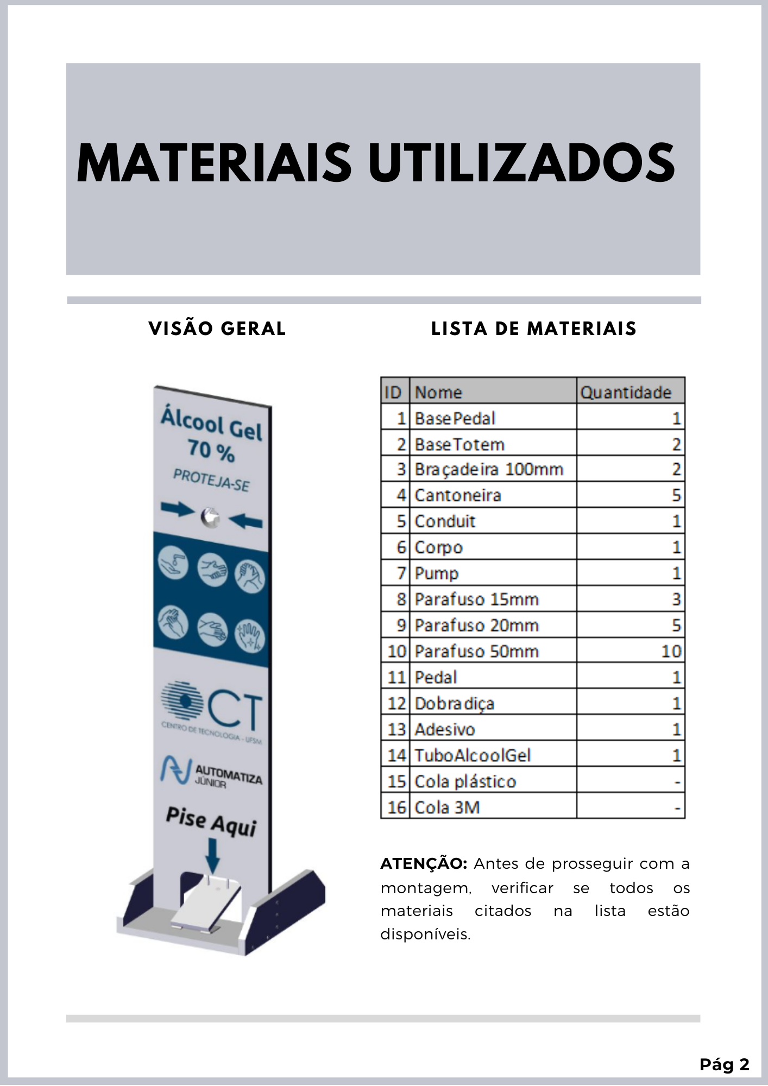
Manual/PNGs/2.png
