iOsnaaente/Totem-Alcool-em-gel/Manual/PNGs/3.png

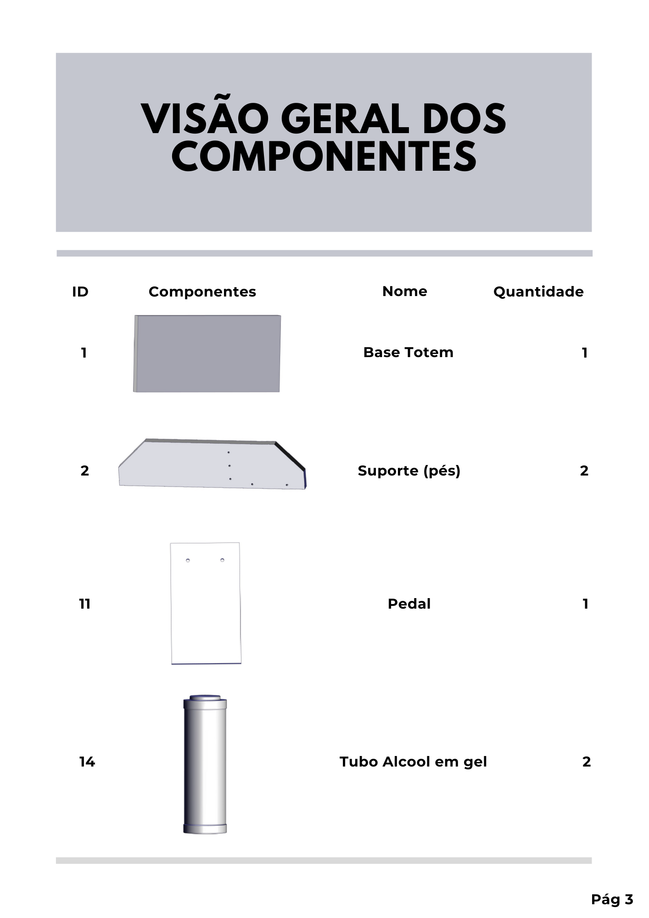
Manual/PNGs/3.png
