iOsnaaente/Totem-Alcool-em-gel/Manual/PNGs/4.png

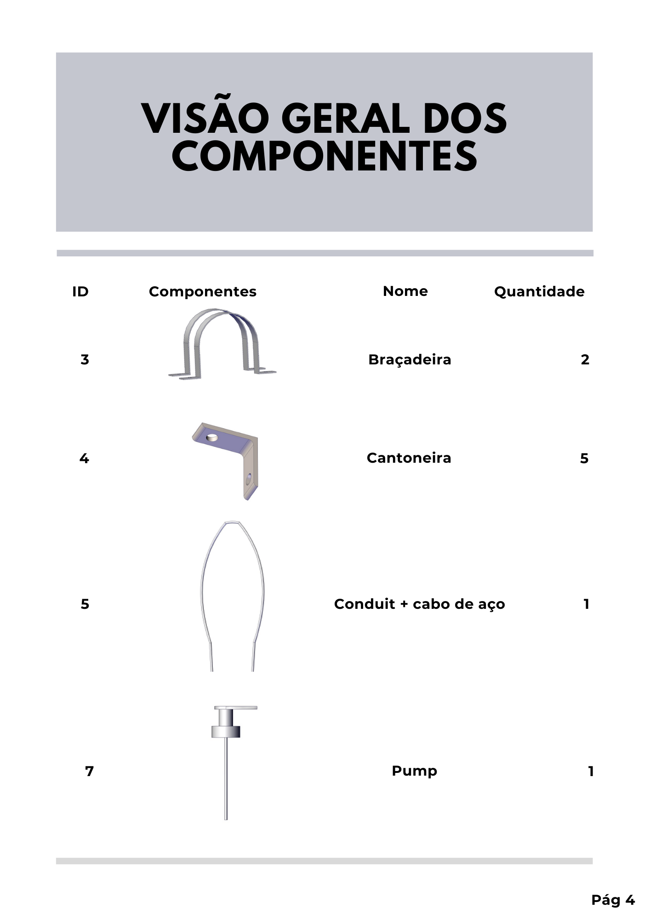
Manual/PNGs/4.png
