iOsnaaente/Totem-Alcool-em-gel/Manual/PNGs/5.png

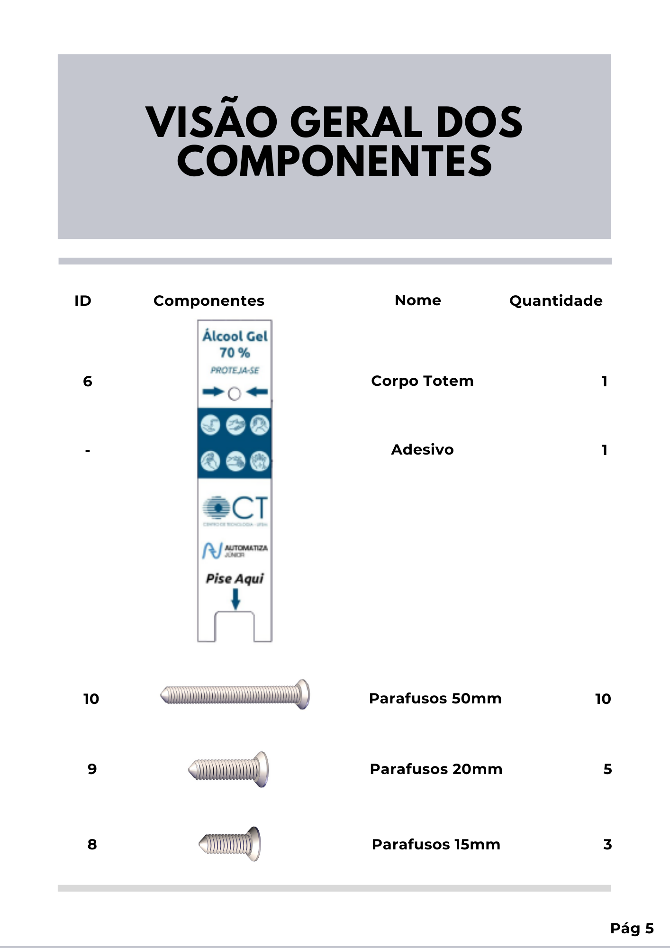
Manual/PNGs/5.png
