iOsnaaente/Totem-Alcool-em-gel/Manual/PNGs/6.png

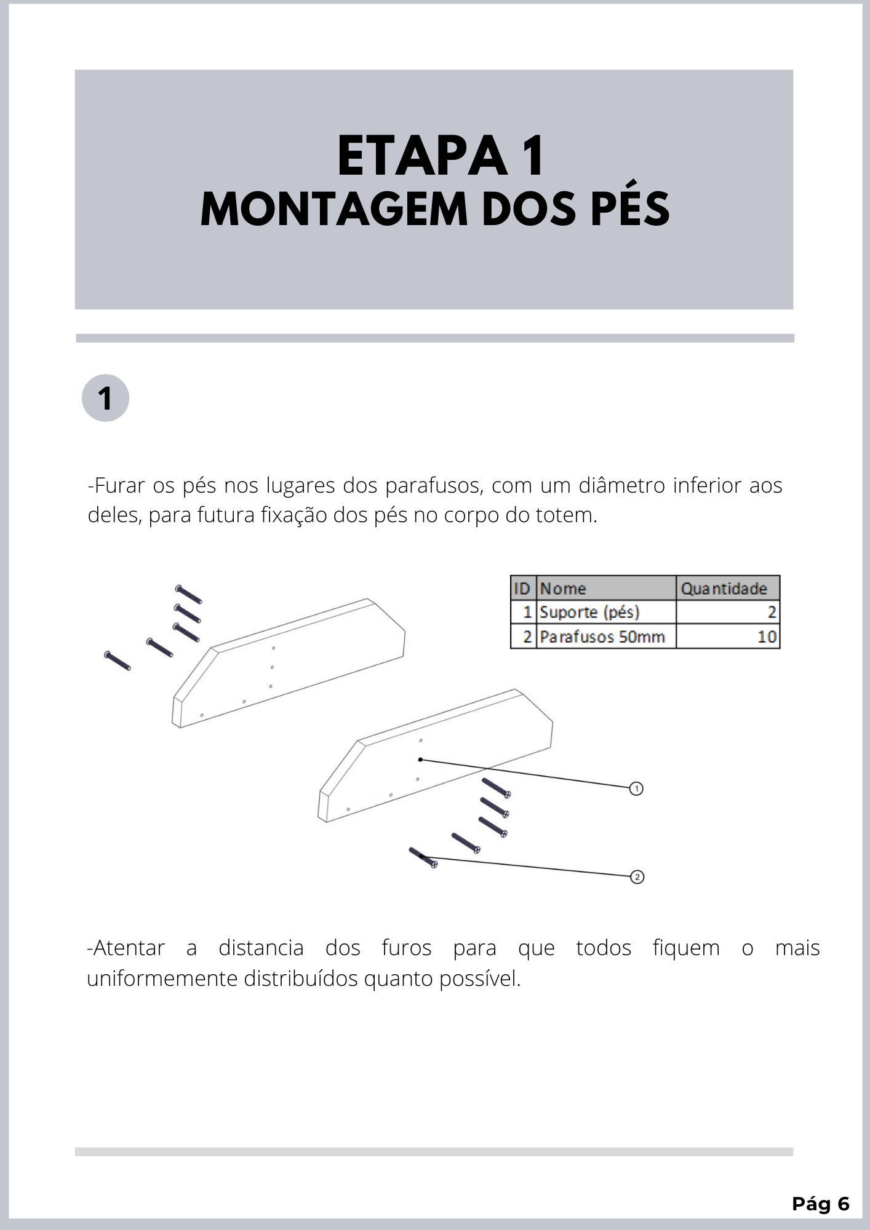
Manual/PNGs/6.png
