iOsnaaente/Totem-Alcool-em-gel/Manual/PNGs/7.png

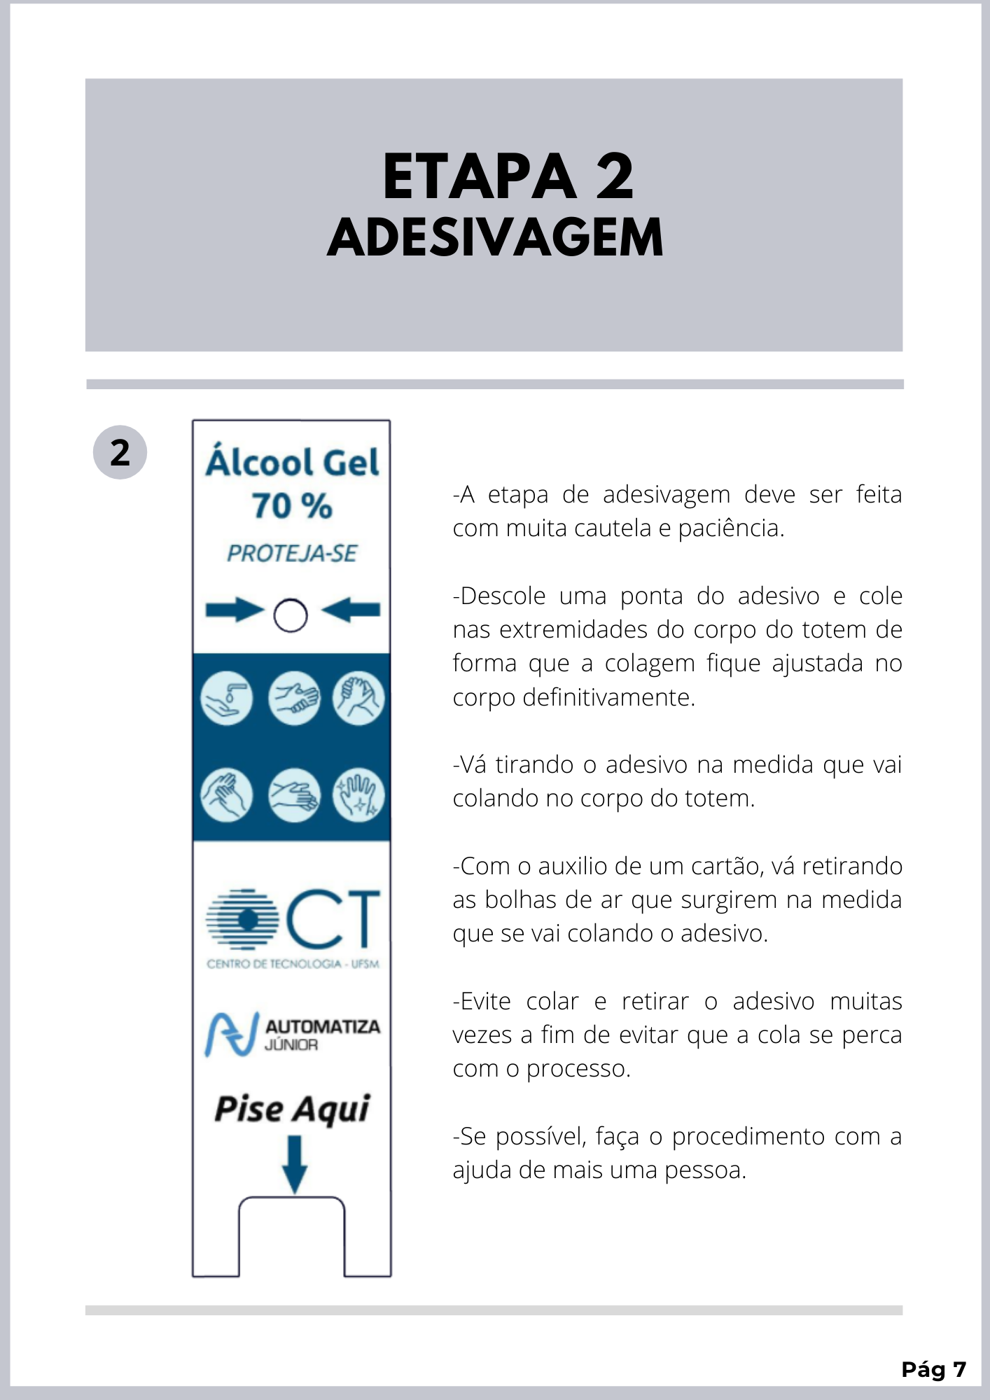
Manual/PNGs/7.png
