iOsnaaente/Totem-Alcool-em-gel/Manual/PNGs/8.png

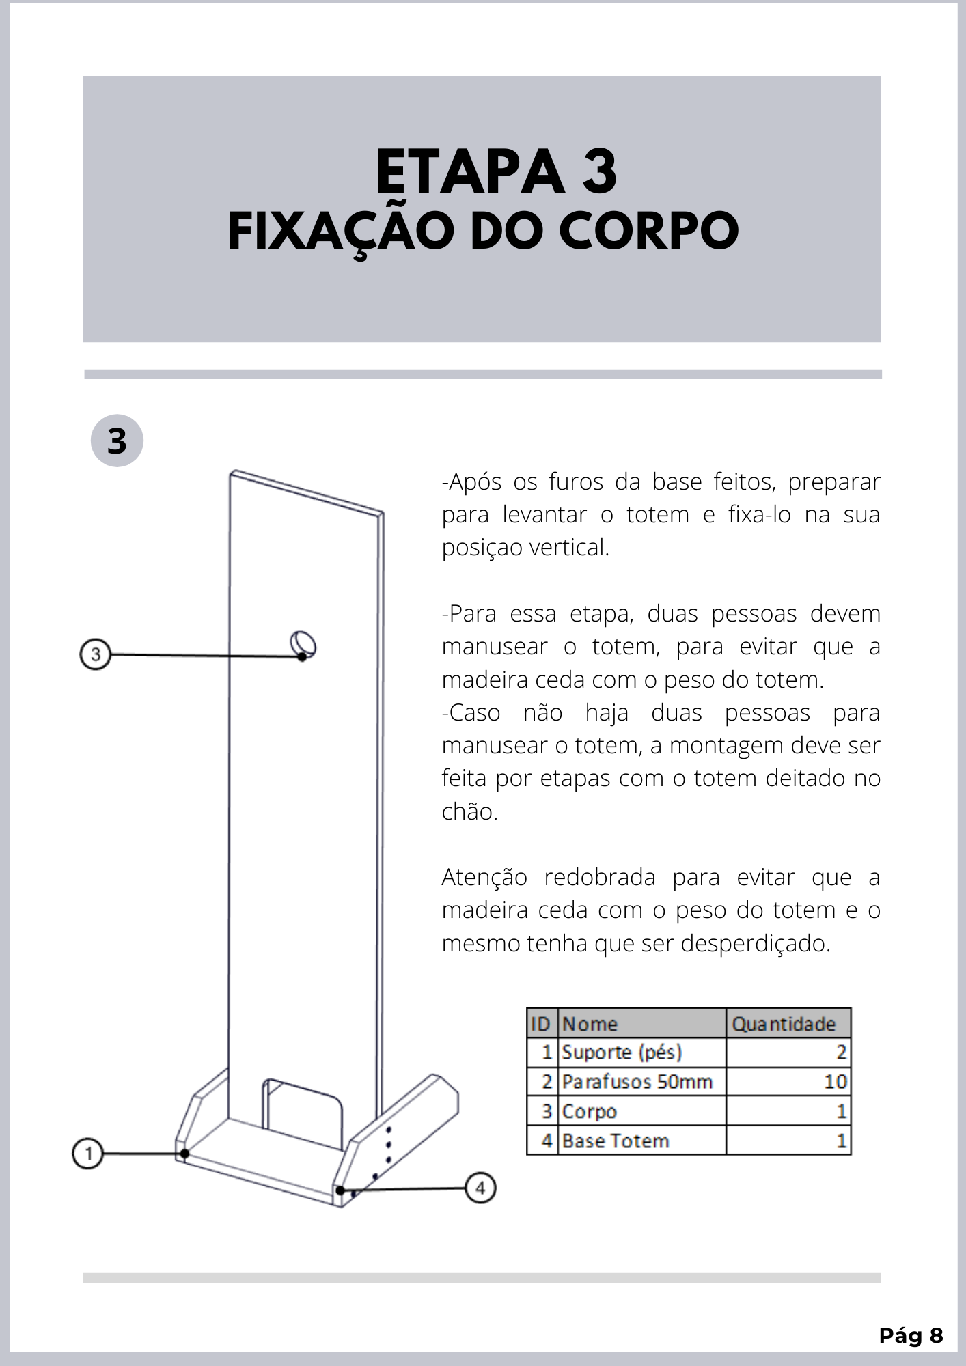
Manual/PNGs/8.png
