iOsnaaente/Totem-Alcool-em-gel/Manual/PNGs/9.png

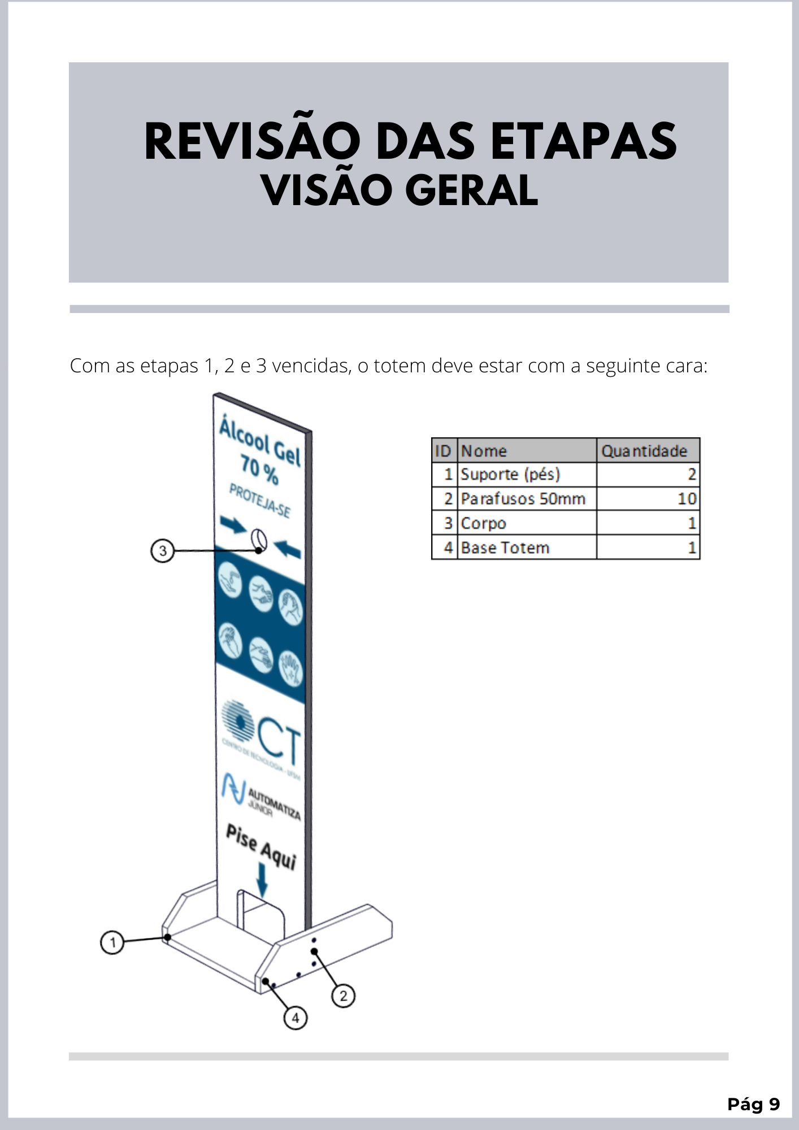
Manual/PNGs/9.png
