iOsnaaente/Totem-Alcool-em-gel/Manual/PNGs/10.png

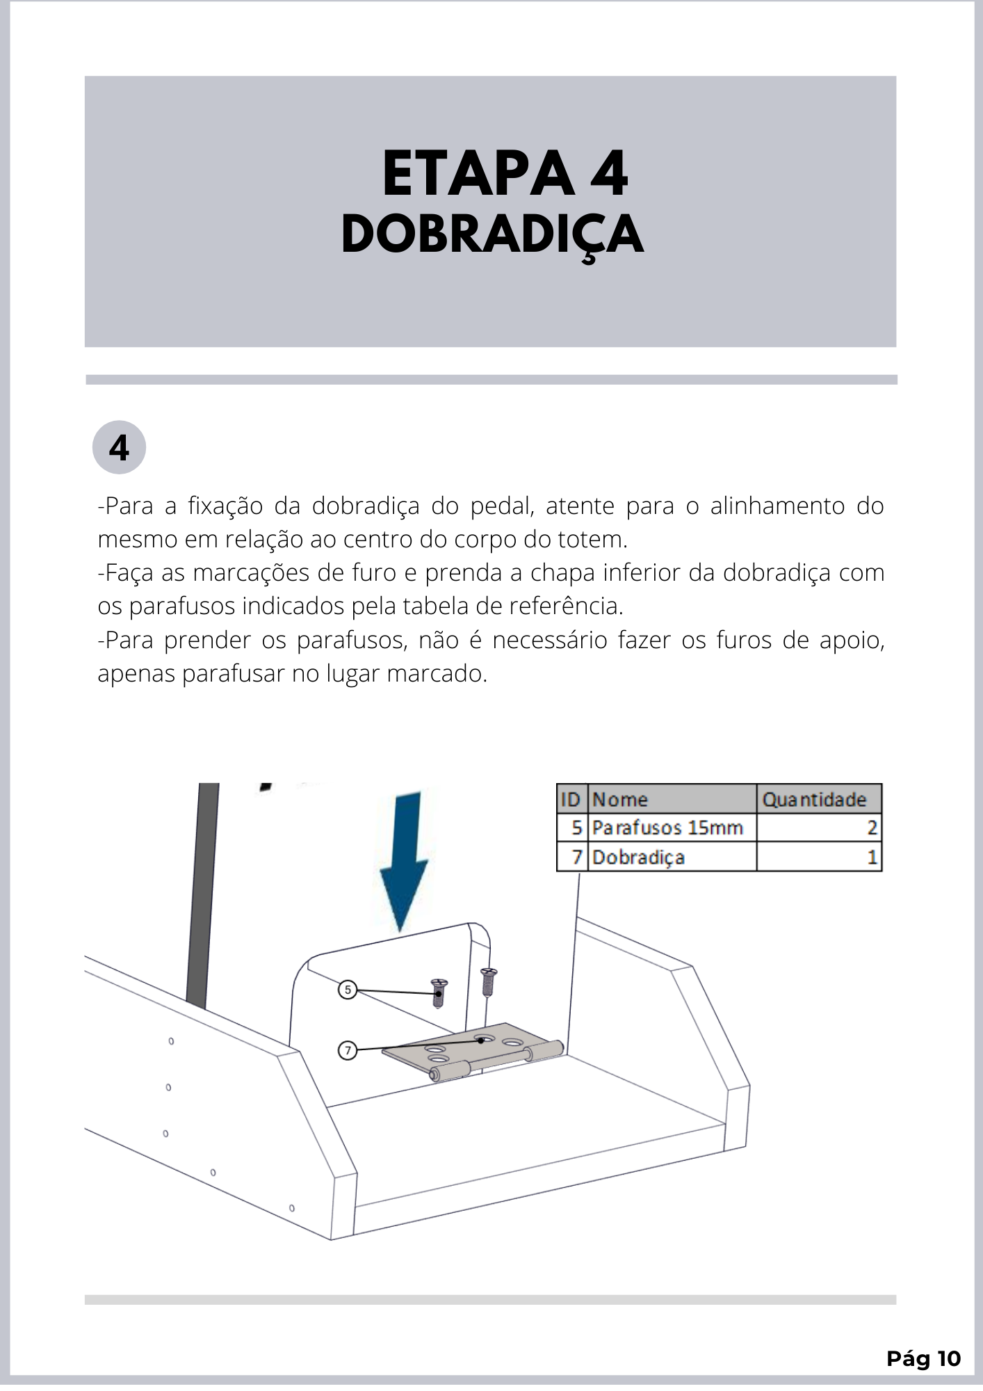
Manual/PNGs/10.png
