iOsnaaente/Totem-Alcool-em-gel/Manual/PNGs/11.png

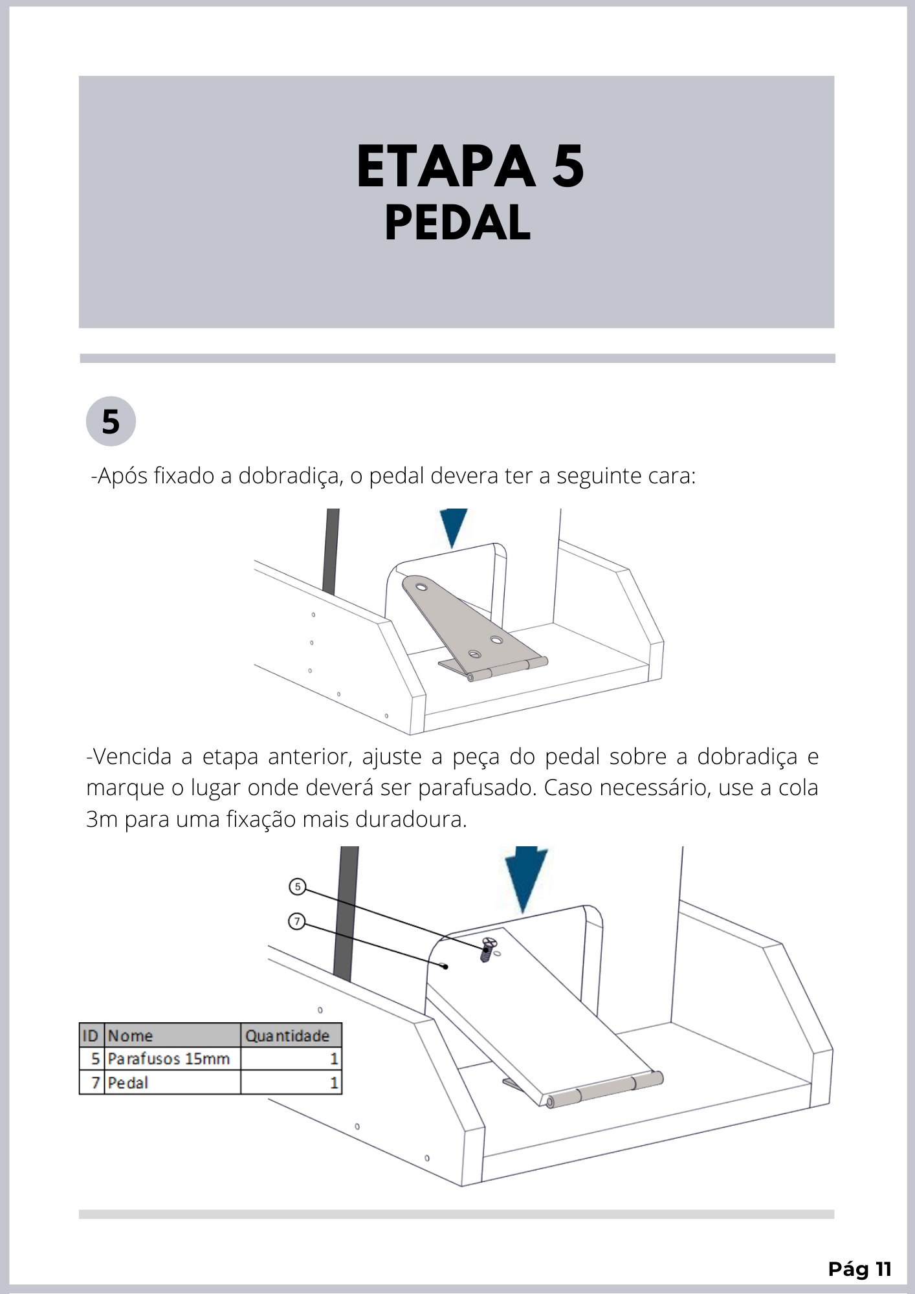
Manual/PNGs/11.png
