iOsnaaente/Totem-Alcool-em-gel/Manual/PNGs/12.png

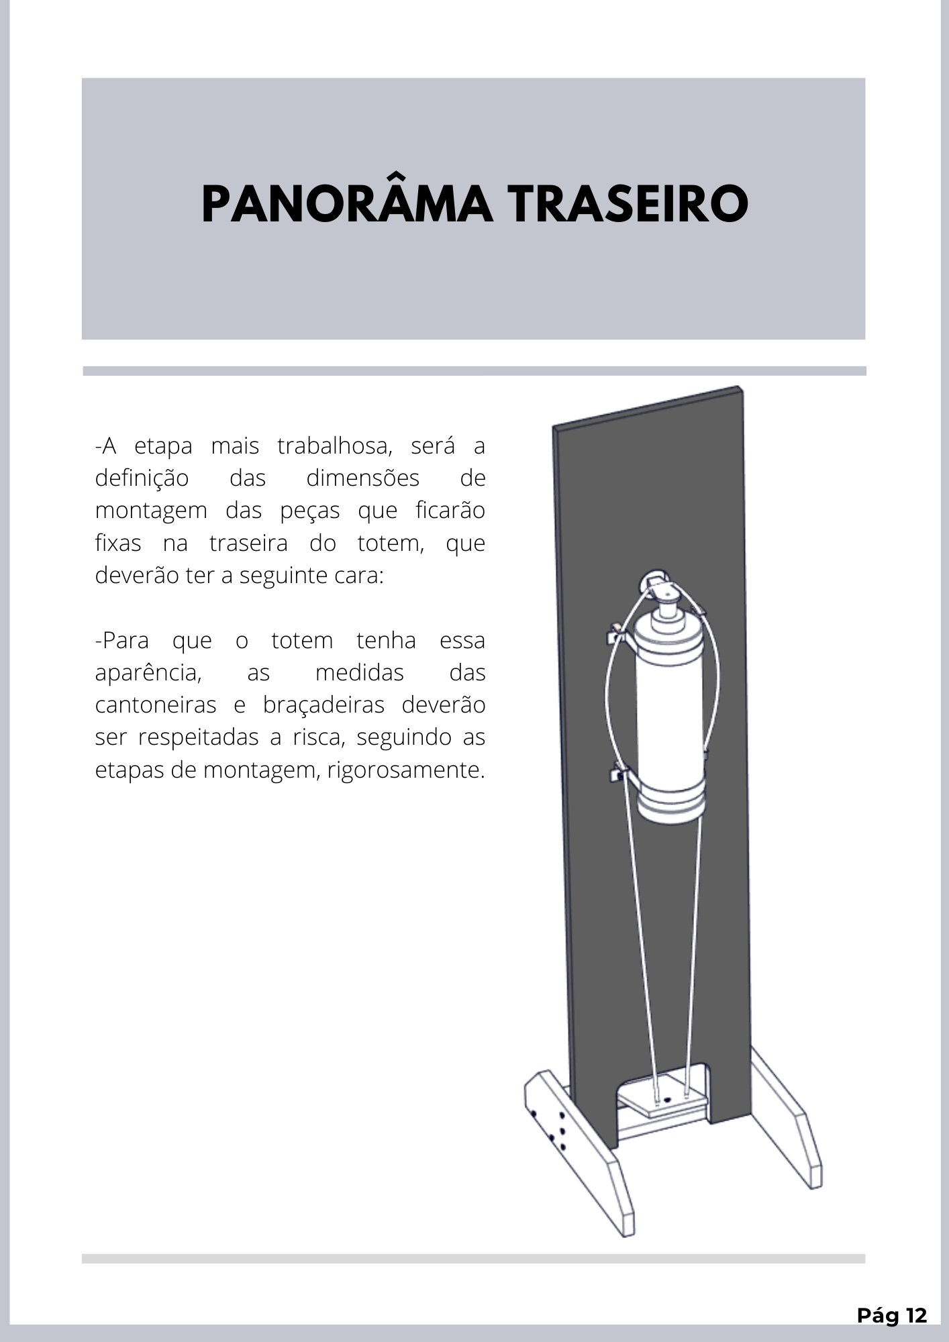
Manual/PNGs/12.png
