iOsnaaente/Totem-Alcool-em-gel/Manual/PNGs/13.png

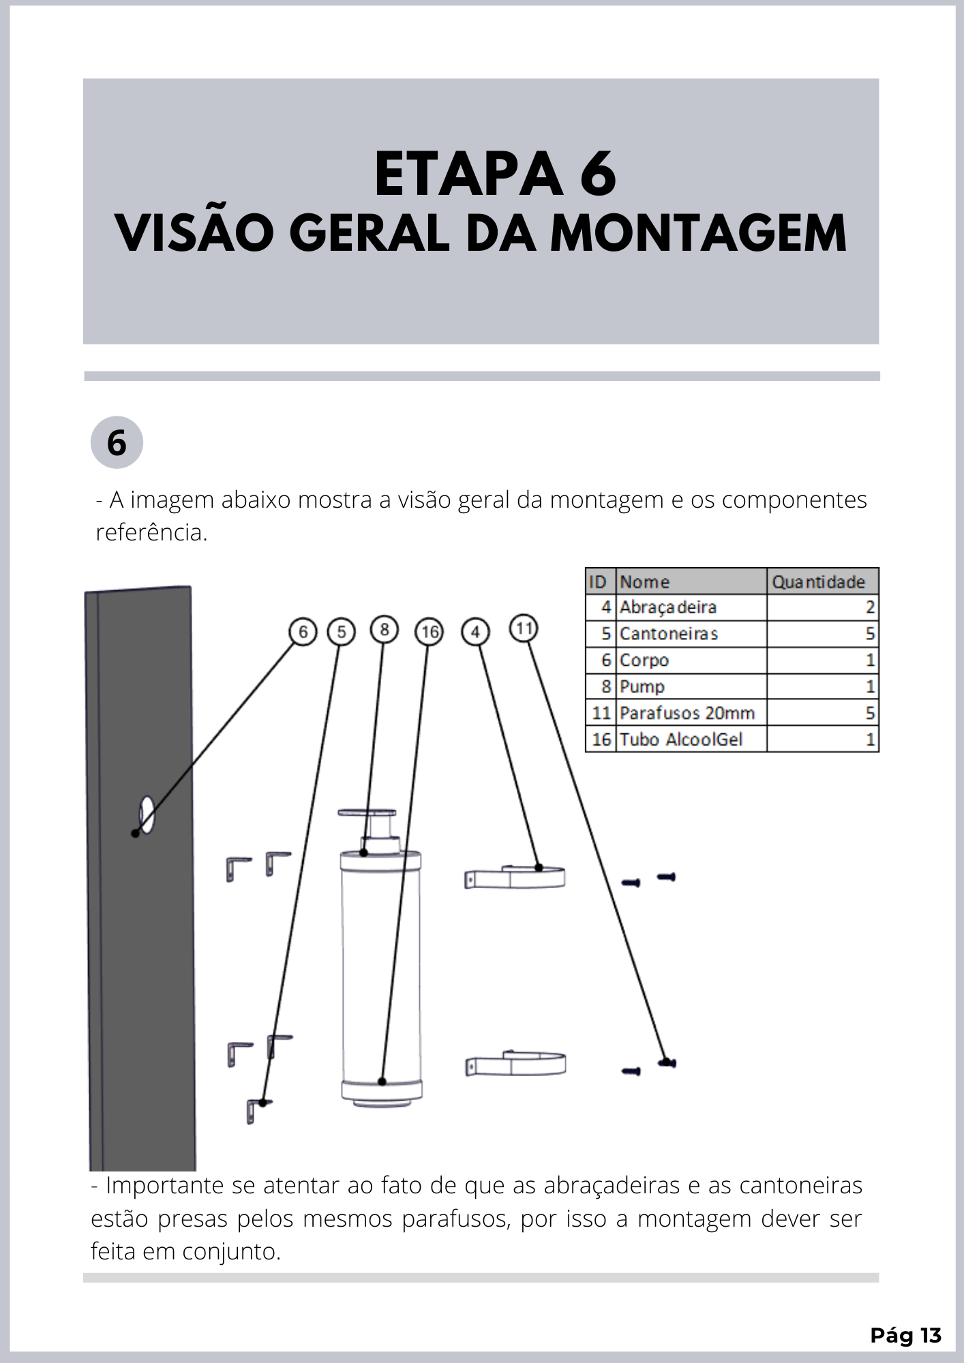
Manual/PNGs/13.png
