iOsnaaente/Totem-Alcool-em-gel/Manual/PNGs/14.png

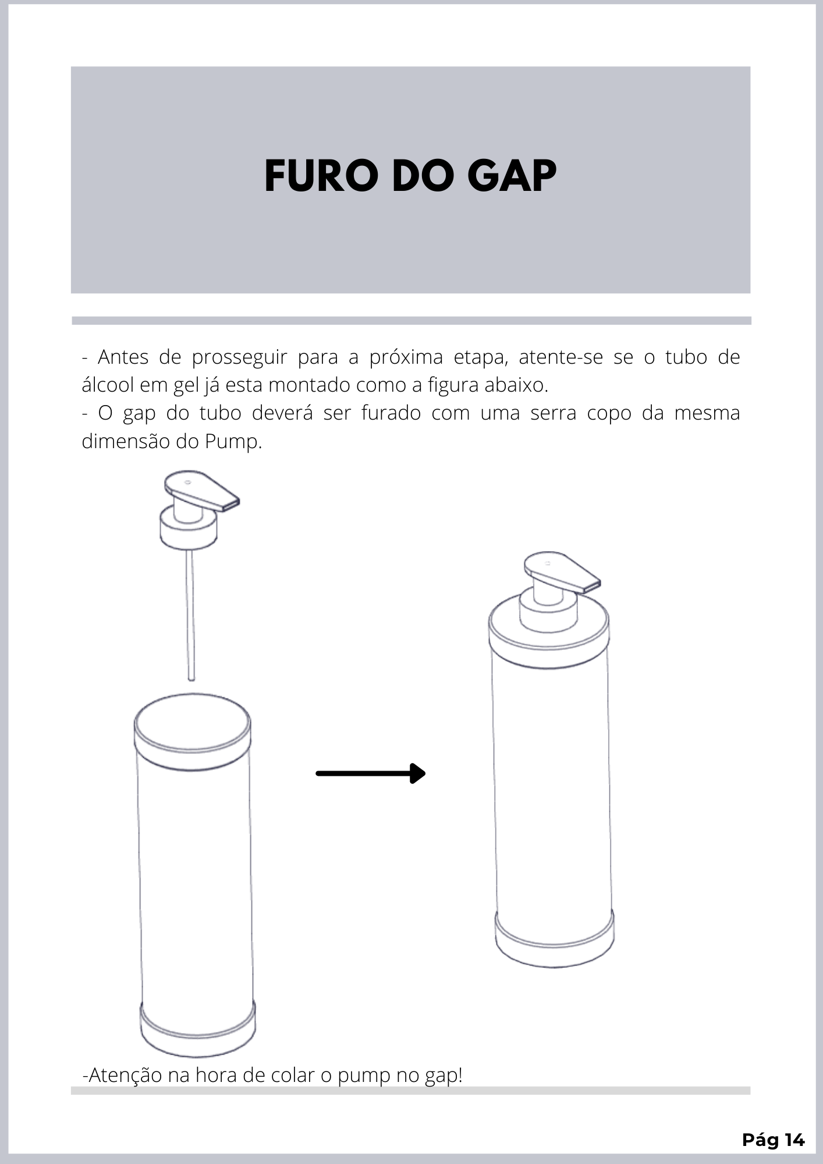
Manual/PNGs/14.png
