iOsnaaente/Totem-Alcool-em-gel/Manual/PNGs/15.png

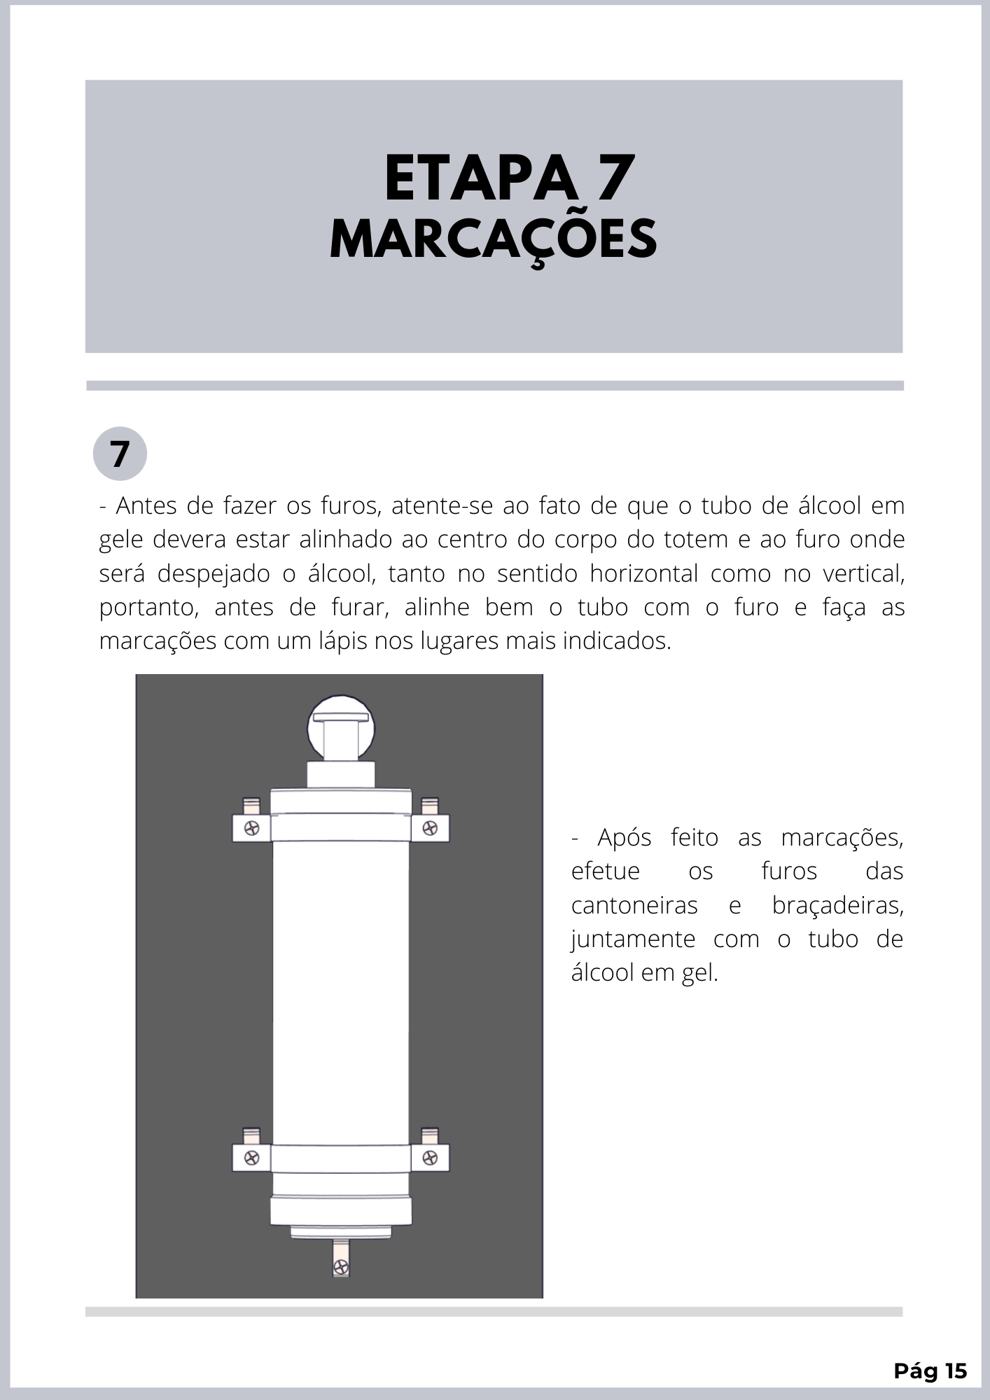
Manual/PNGs/15.png
