iOsnaaente/Totem-Alcool-em-gel/Manual/PNGs/16.png

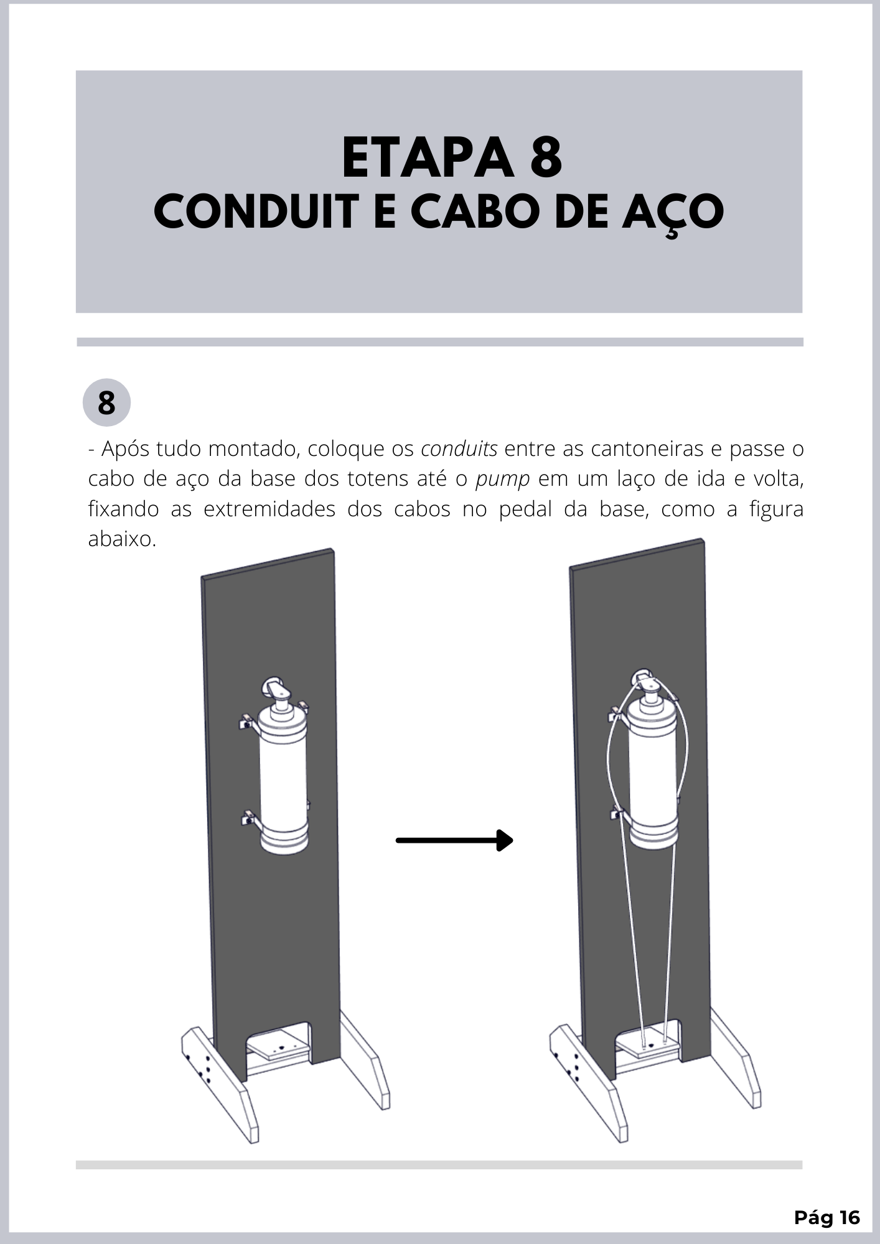
Manual/PNGs/16.png
