iOsnaaente/Totem-Alcool-em-gel/Manual/PNGs/17.png

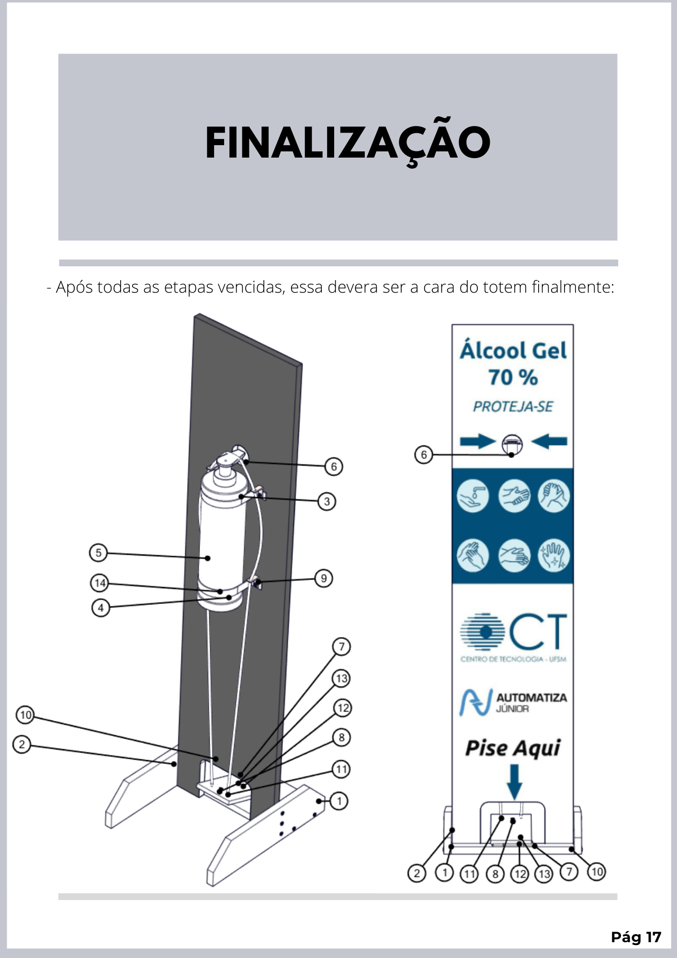
Manual/PNGs/17.png
