iOsnaaente/Totem-Alcool-em-gel/Manual/PNGs/18.png

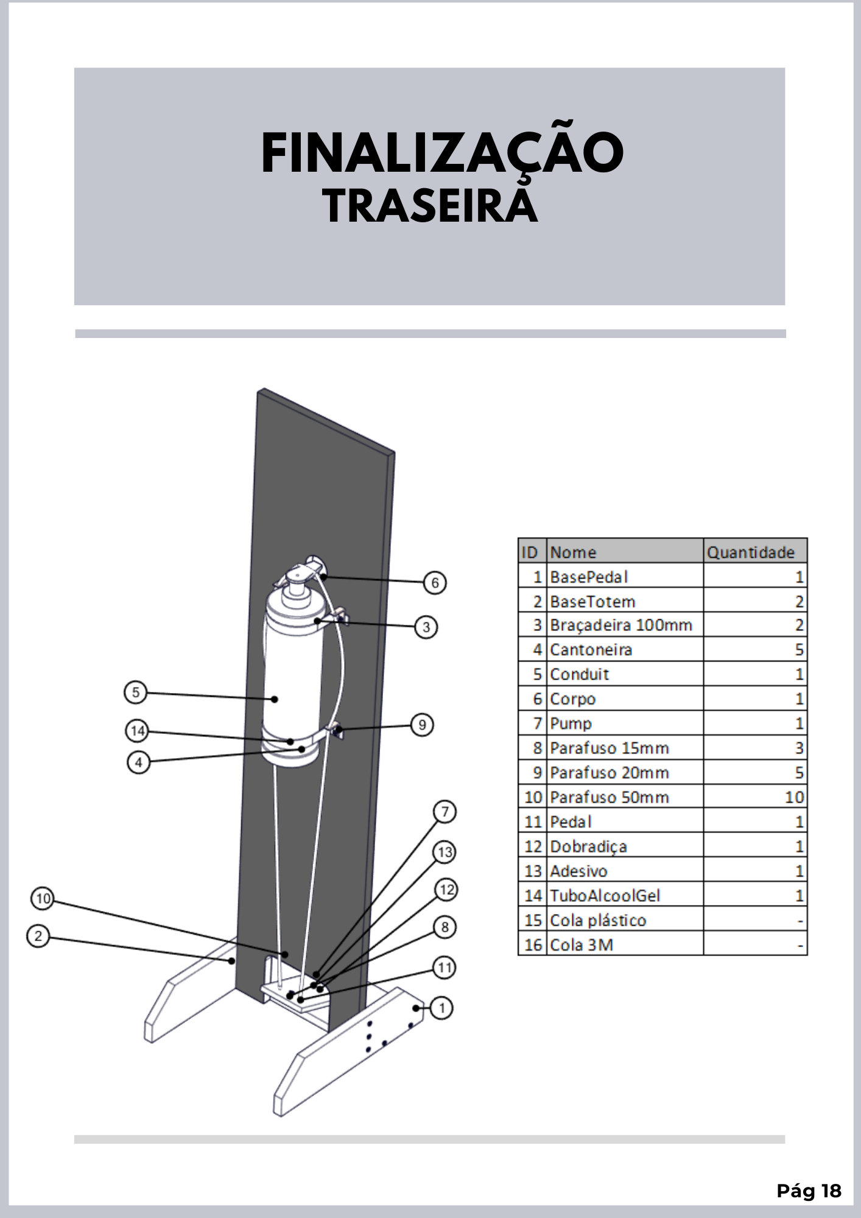
Manual/PNGs/18.png
