iOsnaaente/Totem-Alcool-em-gel/Manual/PNGs/19.png

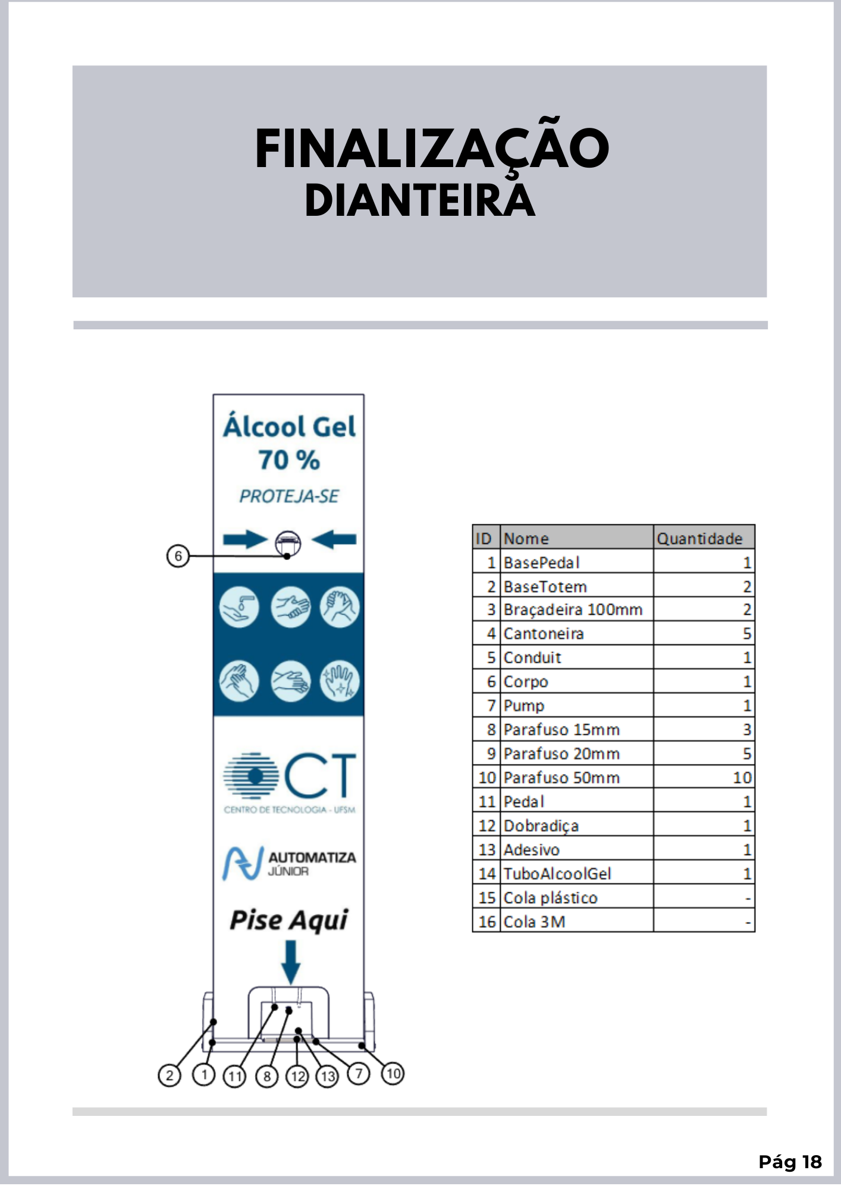
Manual/PNGs/19.png
