iOsnaaente/Totem-Alcool-em-gel/TOTEM_CCNE/TAG-101.PDF

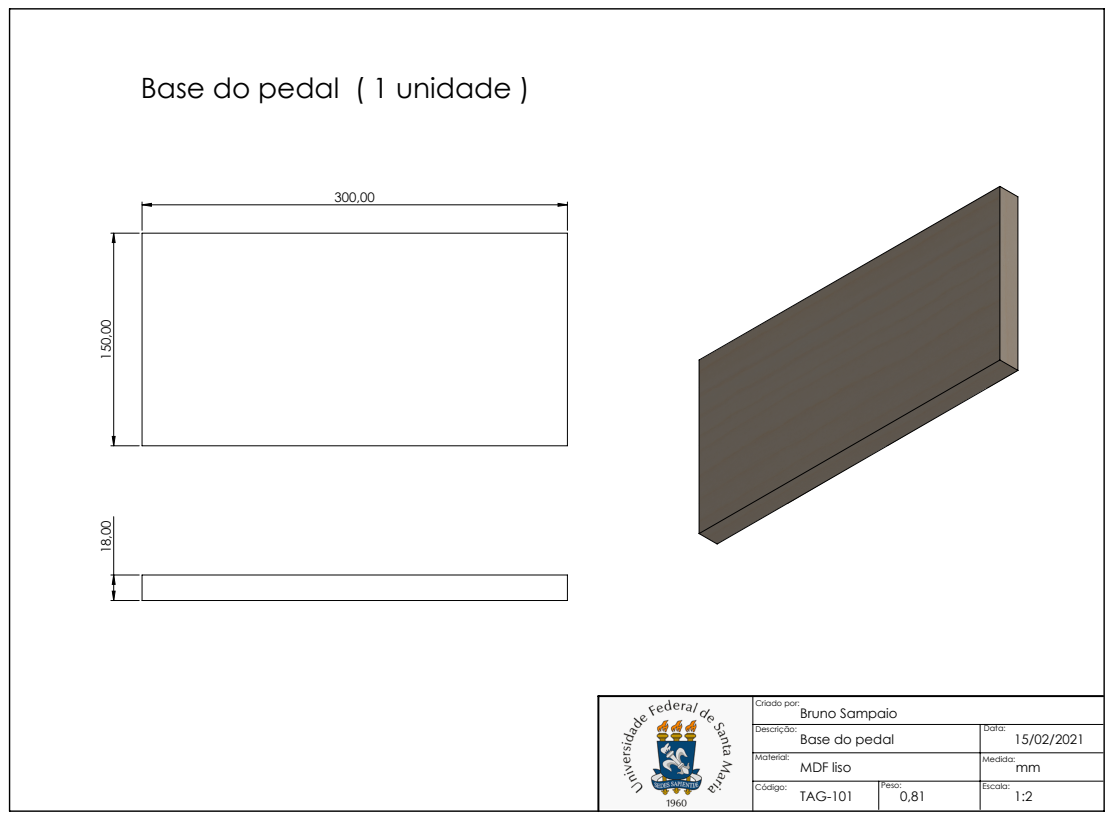
[picture p70: page 1]

Base do pedal ( 1 unidade )

Criado por: Bruno Sampaio
Descrição: Base do pedal | Data: 15/02/2021
Material: MDF liso | Medida: mm
Código: TAG-101 | Peso: 0,81 | Escala: 1:2
