iOsnaaente/Totem-Alcool-em-gel/TOTEM_CCNE/TAG-102.PDF

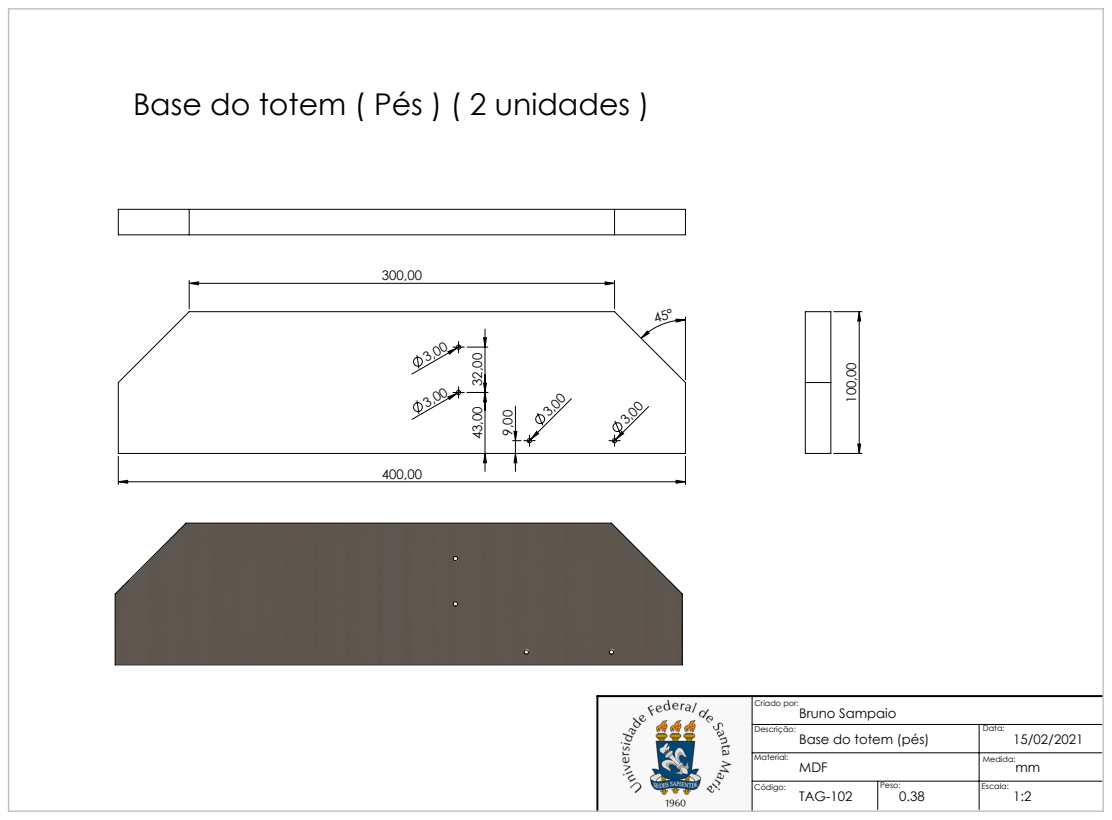
[picture p71: page 1]

Base do totem ( Pés ) ( 2 unidades )

Criado por: Bruno Sampaio
Descrição: Base do totem (pés) | Data: 15/02/2021
Material: MDF | Medida: mm
Código: TAG-102 | Peso: 0.38 | Escala: 1:2
