iOsnaaente/Totem-Alcool-em-gel/TOTEM_CCNE/TAG-103.PDF

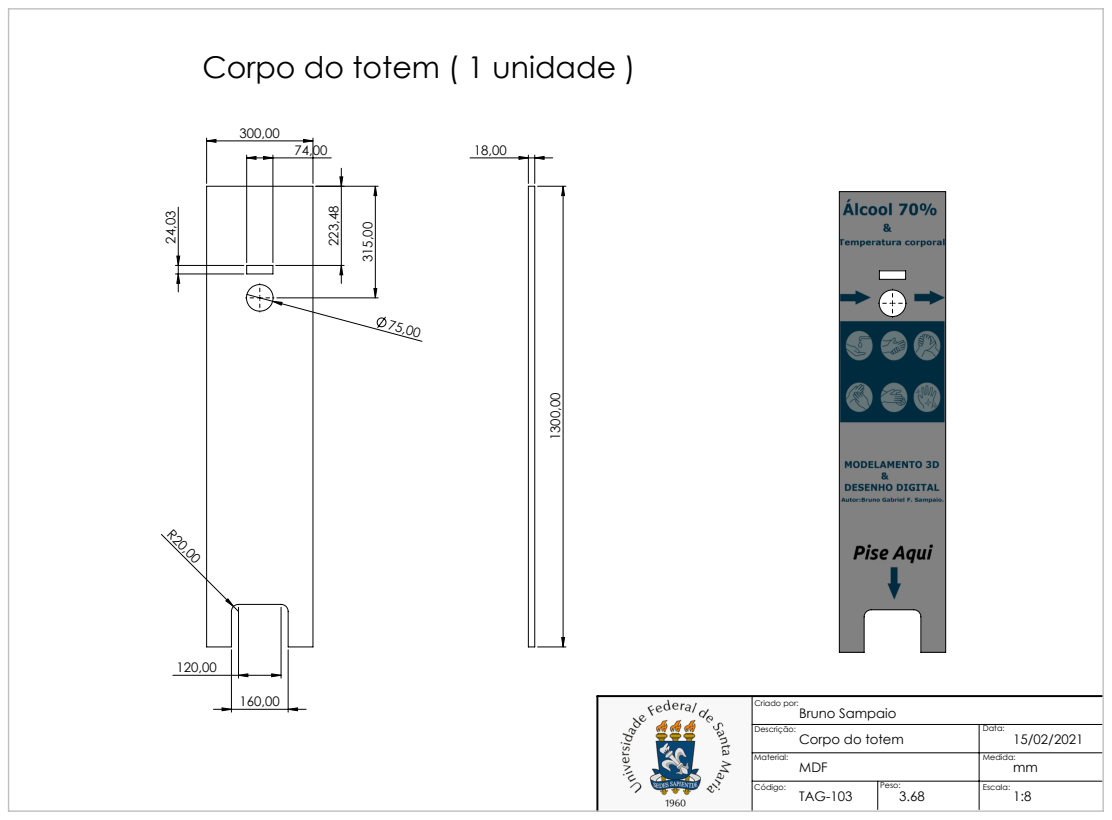
[picture p72: page 1]

Corpo do totem ( 1 unidade )

Criado por: Bruno Sampaio
Descrição: Corpo do totem | Data: 15/02/2021
Material: MDF | Medida: mm
Código: TAG-103 | Peso: 3.68 | Escala: 1:8
