iOsnaaente/Totem-Alcool-em-gel/TOTEM_CCNE/TAG-104.PDF

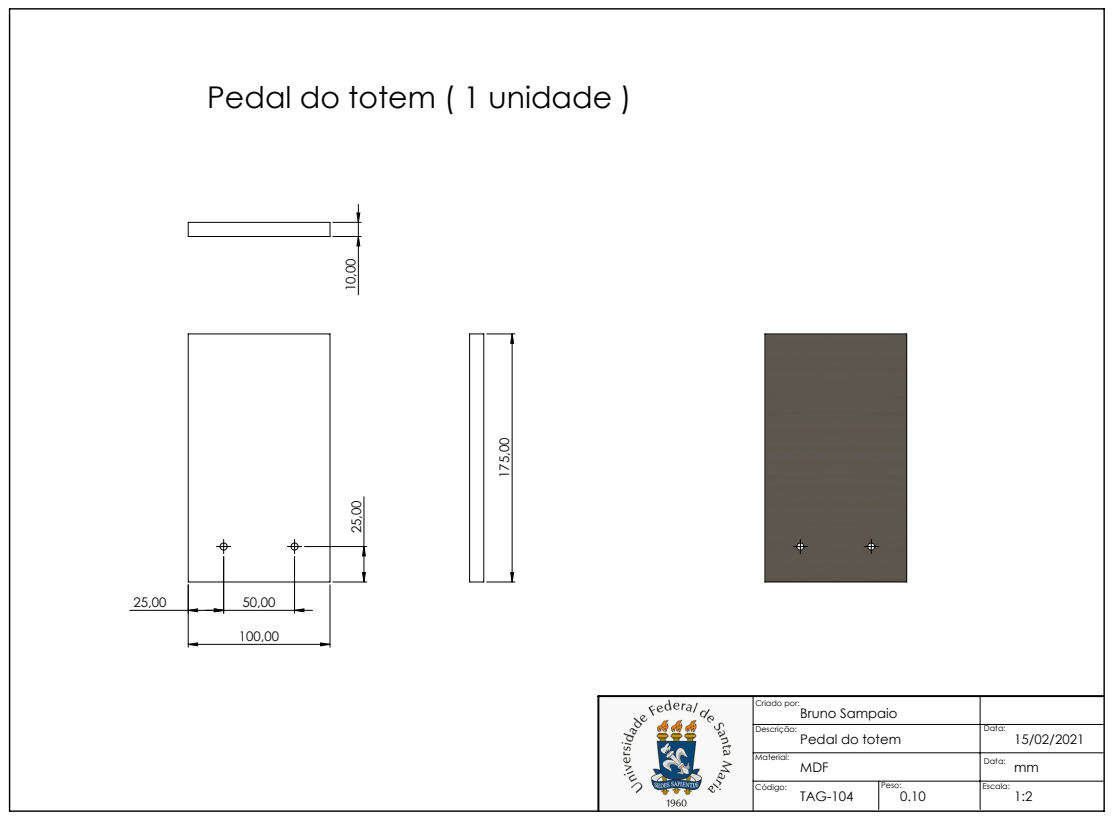
[picture p73: page 1]

Pedal do totem ( 1 unidade )

Criado por: Bruno Sampaio
Descrição: Pedal do totem | Data: 15/02/2021
Material: MDF | Data: mm
Código: TAG-104 | Peso: 0.10 | Escala: 1:2
