iOsnaaente/Totem-Alcool-em-gel/TOTEM_CCNE/TAG-105.PDF

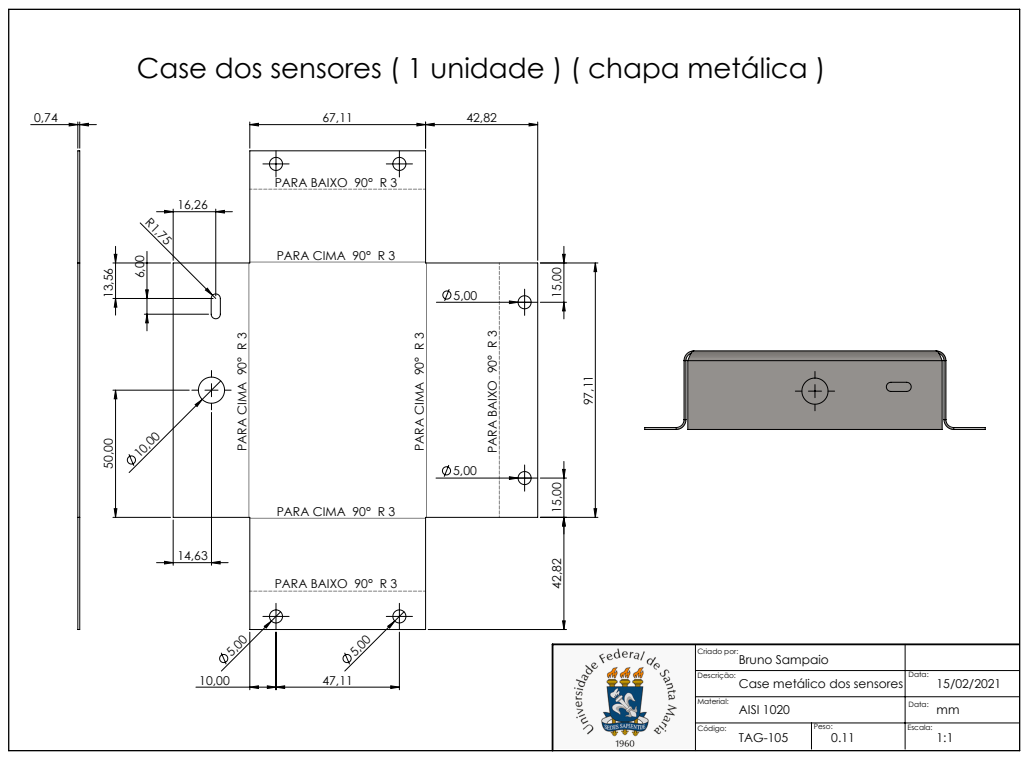
[picture p74: page 1]
PARA BAIXO 90° R 3; PARA CIMA 90° R 3

Case dos sensores ( 1 unidade ) ( chapa metálica )

Criado por: Bruno Sampaio
Descrição: Case metálico dos sensores | Data: 15/02/2021
Material: AISI 1020 | Data: mm
Código: TAG-105 | Peso: 0.11 | Escala: 1:1
