iOsnaaente/Totem-Alcool-em-gel/TOTEM_CCNE/TAG-401.PDF

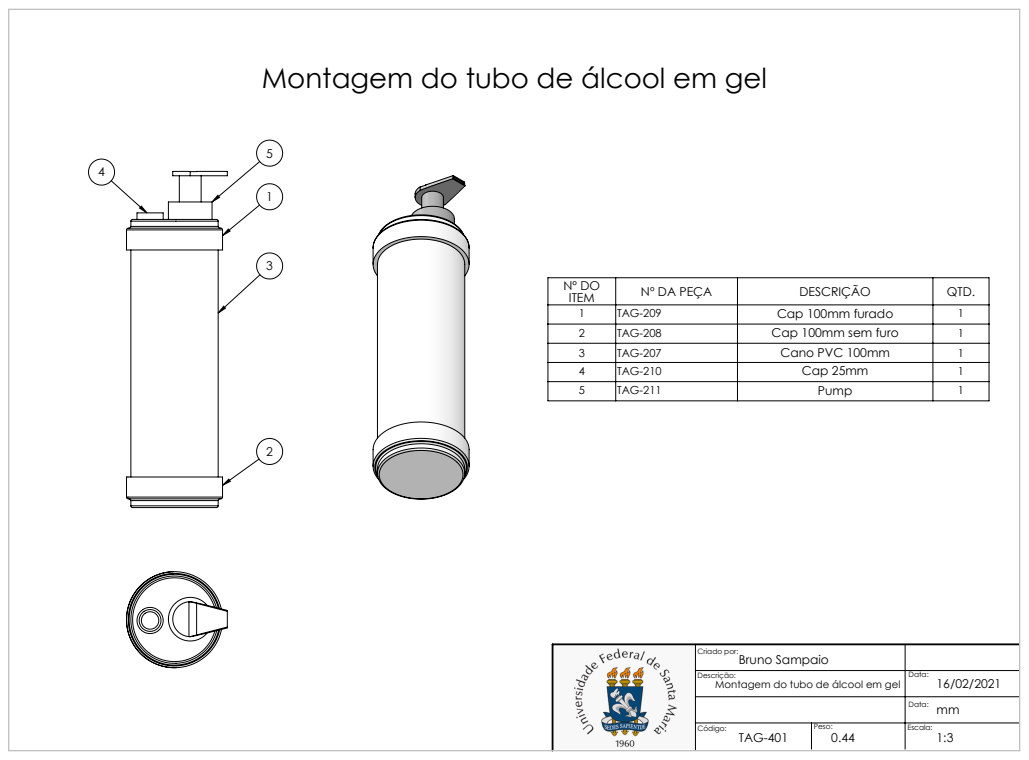
[picture p75: page 1]

Montagem do tubo de álcool em gel

Nº DO ITEM | Nº DA PEÇA | DESCRIÇÃO | QTD.
1 | TAG-209 | Cap 100mm furado | 1
2 | TAG-208 | Cap 100mm sem furo | 1
3 | TAG-207 | Cano PVC 100mm | 1
4 | TAG-210 | Cap 25mm | 1
5 | TAG-211 | Pump | 1

Criado por: Bruno Sampaio
Descrição: Montagem do tubo de álcool em gel | Data: 16/02/2021

Data: mm

Código: TAG-401 | Peso: 0.44 | Escala: 1:3
