iOsnaaente/Totem-Alcool-em-gel/TOTEM_CCNE/TAG-501.PDF

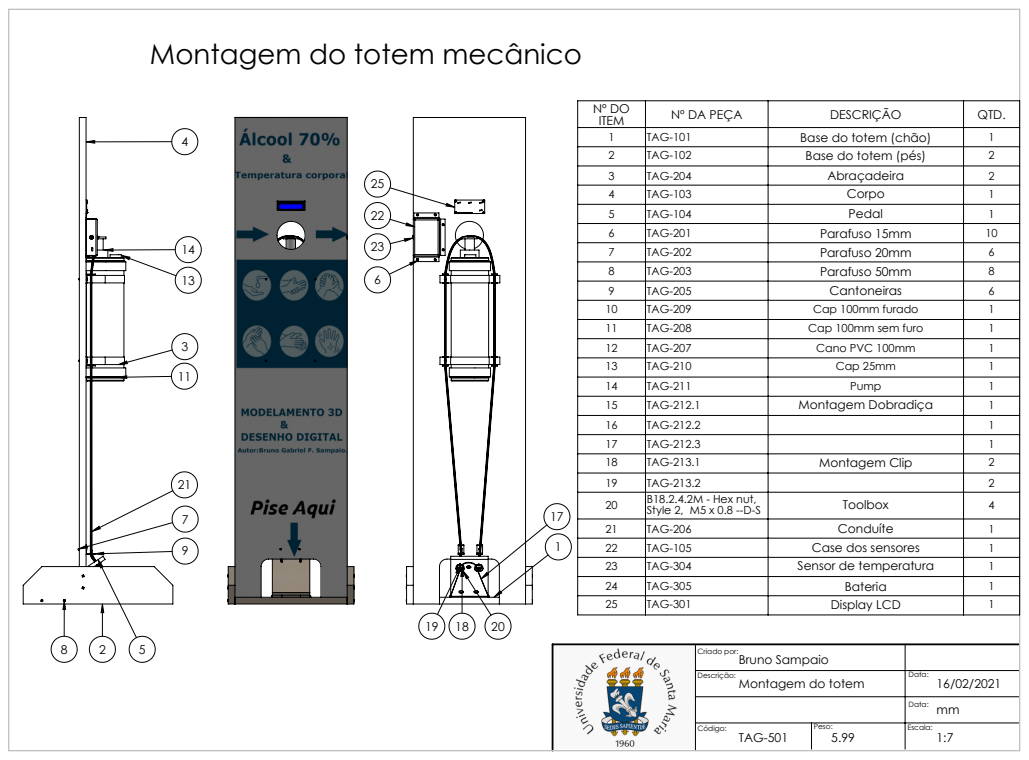
[picture p76: page 1]

Montagem do totem mecânico

Nº DO ITEM | Nº DA PEÇA | DESCRIÇÃO | QTD.
1 | TAG-101 | Base do totem (chão) | 1
2 | TAG-102 | Base do totem (pés) | 2
3 | TAG-204 | Abraçadeira | 2
4 | TAG-103 | Corpo | 1
5 | TAG-104 | Pedal | 1
6 | TAG-201 | Parafuso 15mm | 10
7 | TAG-202 | Parafuso 20mm | 6
8 | TAG-203 | Parafuso 50mm | 8
9 | TAG-205 | Cantoneiras | 6
10 | TAG-209 | Cap 100mm furado | 1
11 | TAG-208 | Cap 100mm sem furo | 1
12 | TAG-207 | Cano PVC 100mm | 1
13 | TAG-210 | Cap 25mm | 1
14 | TAG-211 | Pump | 1
15 | TAG-212.1 | Montagem Dobradiça | 1
16 | TAG-212.2 | | 1
17 | TAG-212.3 | | 1
18 | TAG-213.1 | Montagem Clip | 2
19 | TAG-213.2 | | 2
20 | B18.2.4.2M - Hex nut, Style 2, M5 x 0.8 --D-S | Toolbox | 4
21 | TAG-206 | Conduíte | 1
22 | TAG-105 | Case dos sensores | 1
23 | TAG-304 | Sensor de temperatura | 1
24 | TAG-305 | Bateria | 1
25 | TAG-301 | Display LCD | 1

Criado por: Bruno Sampaio
Descrição: Montagem do totem | Data: 16/02/2021

Data: mm

Código: TAG-501 | Peso: 5.99 | Escala: 1:7
