iOsnaaente/Totem-Alcool-em-gel/TotemDesTec.PDF

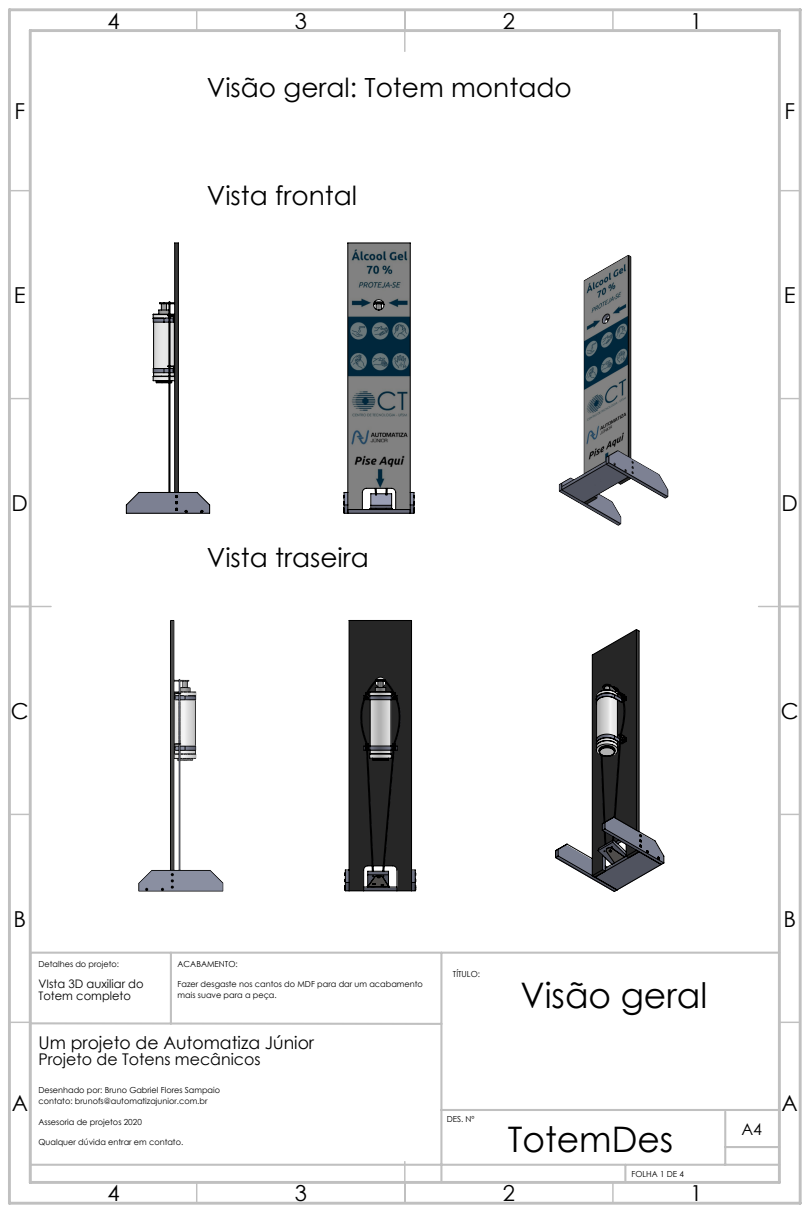
[picture p77: page 1]
Vista frontal; Vista traseira

Visão geral: Totem montado

Detalhes do projeto: VIsta 3D auxiliar do Totem completo | ACABAMENTO: Fazer desgaste nos cantos do MDF para dar um acabamento mais suave para a peça. | TÍTULO: Visão geral

Um projeto de Automatiza Júnior
Projeto de Totens mecânicos
contato: brunofs@automatizajunior.com.br
Assesoria de projetos 2020
Qualquer dúvida entrar em contato.

Desenhado por: Bruno Gabriel Flores Sampaio

DES. Nº | A4 TotemDes

FOLHA 1 DE 4

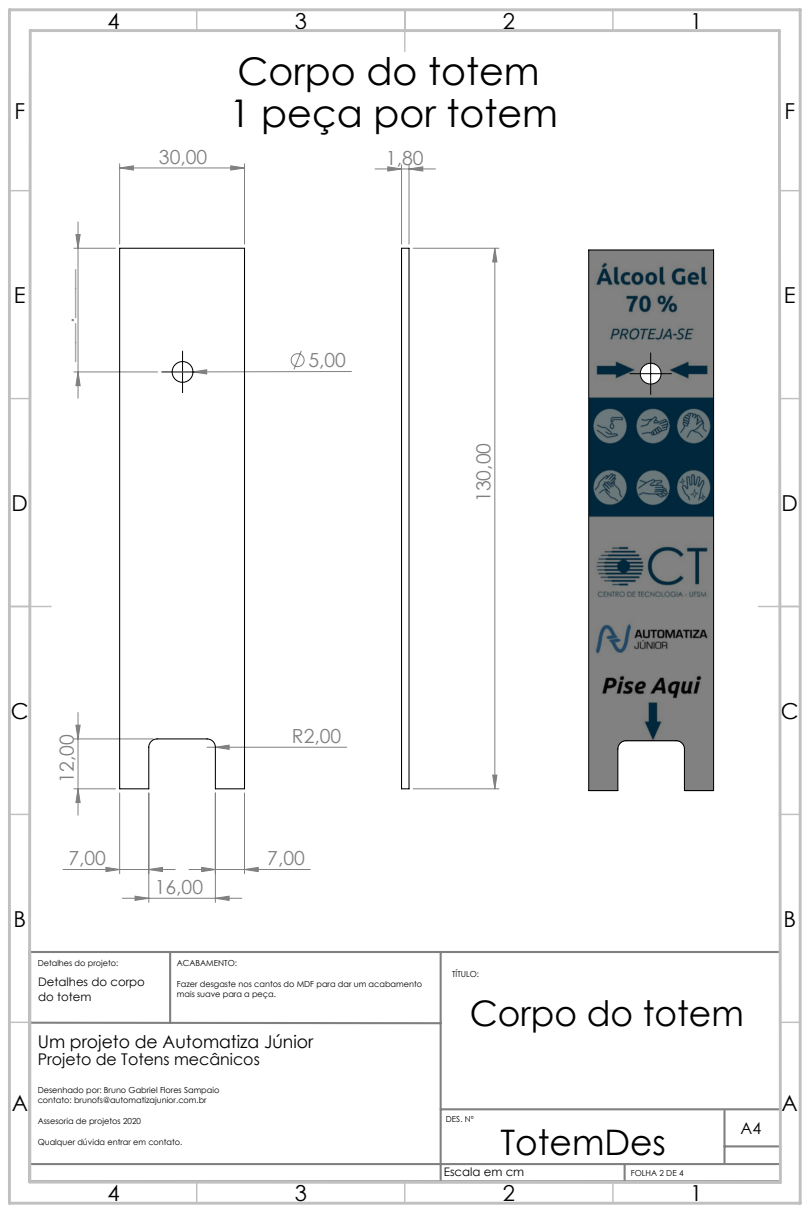
[picture p78: page 2]

Corpo do totem
1 peça por totem

Detalhes do projeto: Detalhes do corpo do totem | ACABAMENTO: Fazer desgaste nos cantos do MDF para dar um acabamento mais suave para a peça. | TÍTULO: Corpo do totem

Um projeto de Automatiza Júnior
Projeto de Totens mecânicos
contato: brunofs@automatizajunior.com.br

Desenhado por: Bruno Gabriel Flores Sampaio

DES. Nº

Escala em cm | FOLHA 2 DE 4

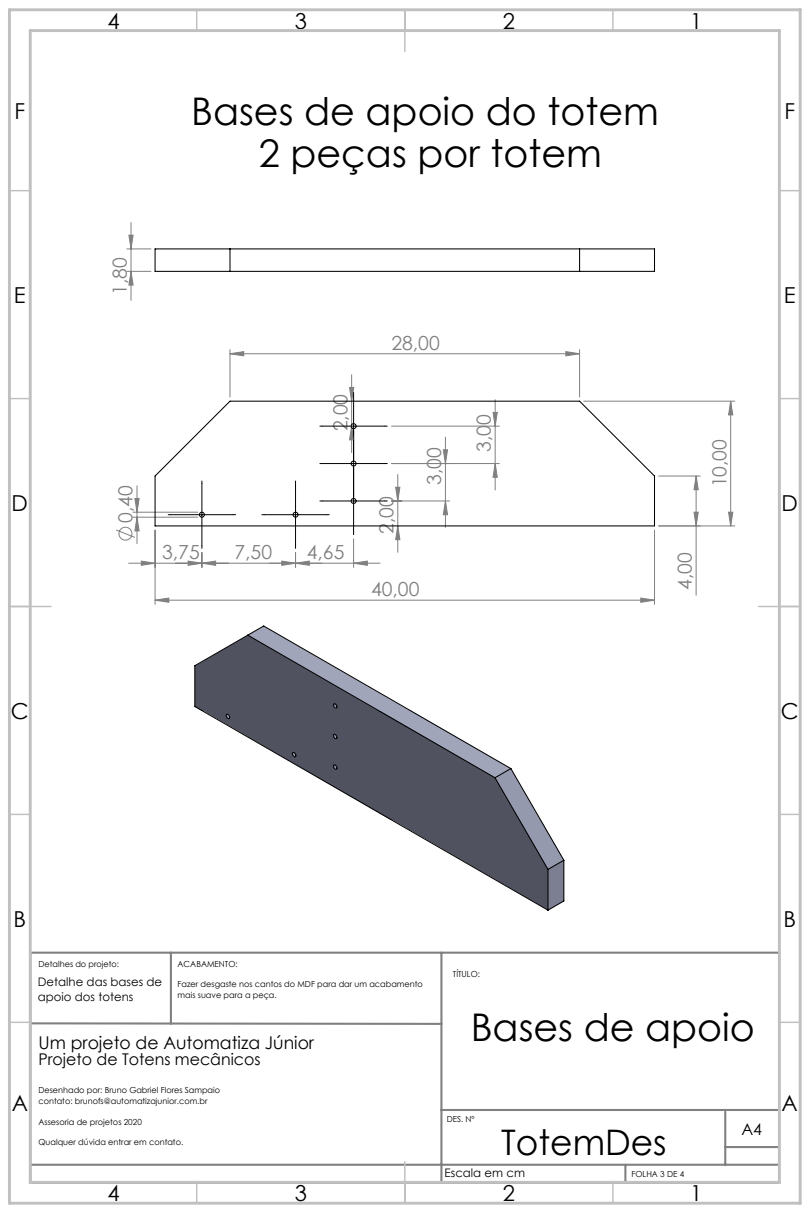
[picture p79: page 3]

Bases de apoio do totem
2 peças por totem

Detalhes do projeto: Detalhe das bases de apoio dos totens | ACABAMENTO: Fazer desgaste nos cantos do MDF para dar um acabamento mais suave para a peça. | TÍTULO: Bases de apoio

Um projeto de Automatiza Júnior
Projeto de Totens mecânicos
contato: brunofs@automatizajunior.com.br

Desenhado por: Bruno Gabriel Flores Sampaio

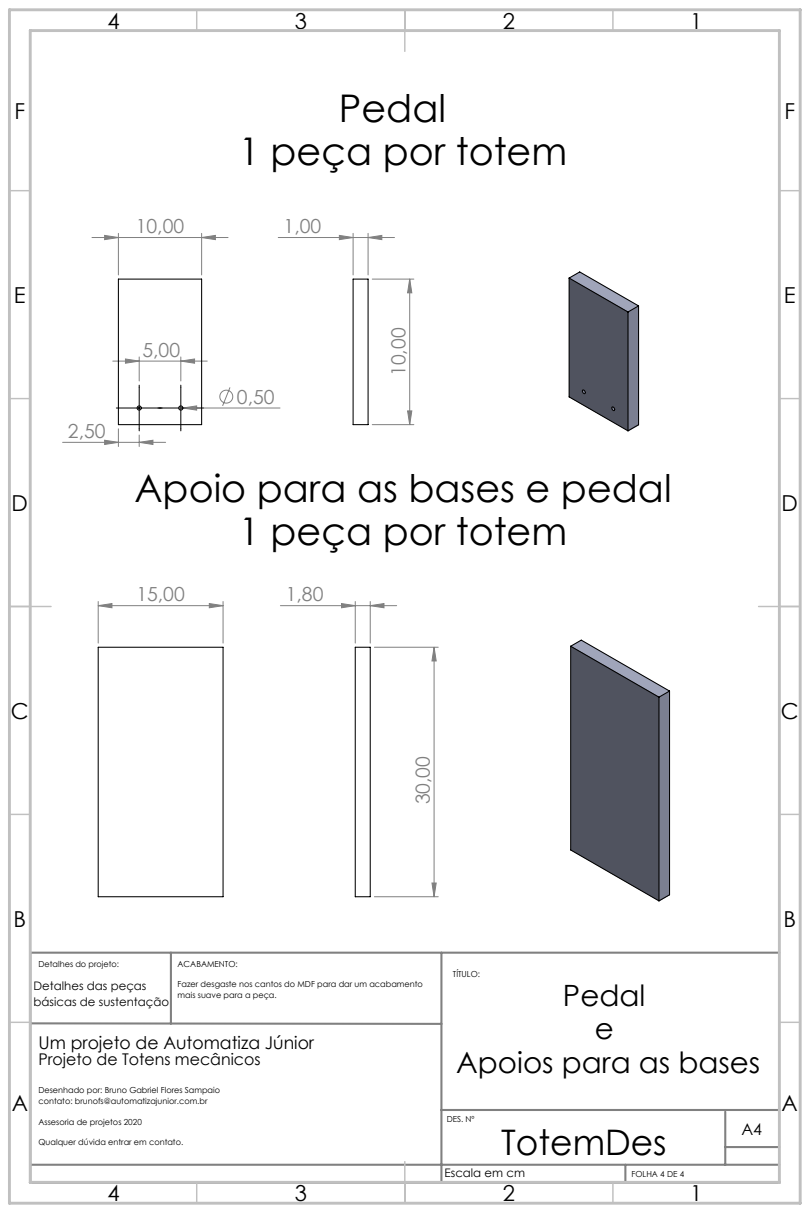
[picture p80: page 4]

Pedal
1 peça por totem

Apoio para as bases e pedal

Detalhes do projeto: Detalhes das peças básicas de sustentação | ACABAMENTO: Fazer desgaste nos cantos do MDF para dar um acabamento mais suave para a peça. | TÍTULO: Pedal e Apoios para as bases

Um projeto de Automatiza Júnior
Projeto de Totens mecânicos
contato: brunofs@automatizajunior.com.br

Desenhado por: Bruno Gabriel Flores Sampaio
