iOsnaaente/Totem-Alcool-em-gel/(commit log)

2021-01-19 Add Manual
    [Conduit_Cabo-de-aço.sldprt, Pedal.sldprt, Totem.SLDASM, TotemDes.SLDDRW, TotemDesTec.SLDDRW, Totem_peças.xls]
2021-02-19 Adicionado a versão do CCNE mais completa com codificação
    [BaseTotem.SLDPRT, Conduit_Cabo-de-aço.sldprt, ESP-NodeMCU-32S.step, TAG-101.SLDDRW, TAG-101.sldprt, TAG-102.SLDDRW, TAG-102.SLDPRT, TAG-103.SLDDRW]
